sfandetti/meetorbit/LICENSING.md

# Licensing

Copyright (c) 2026 Seth Fandetti for original Orbit work.

- Original software, firmware, website and software documentation: **MIT**, see root `LICENSE`.
- Original Capsule hardware design files, CAD, STL, 3MF, wiring and build documentation under `hardware/`: **CERN-OHL-P-2.0**, see `hardware/LICENSE` and `hardware/NOTICE.md`.
- Font files and rasterized font data retain their upstream **SIL Open Font License 1.1** notices in `software/console/fonts/*-OFL.txt`. They are not relicensed as MIT.
- Third-party dependencies and their trademarks retain their respective terms. See `THIRD_PARTY_NOTICES.md`.

Neither license grants rights in third-party trademarks or implies endorsement by AI providers, Philips Hue, Espressif or component manufacturers. These files document a prototype and are supplied without warranty under the applicable licenses.
