sfandetti/meetorbit/THIRD_PARTY_NOTICES.md

# Third-party notices

- `ws` is installed from the pinned package lock by `npm ci`; node_modules is not distributed. Its upstream license remains applicable.
- Office, Retro, Cyber and Bubble fonts and firmware rasterized font data retain SIL Open Font License 1.1 notices in `software/console/fonts/*-OFL.txt`. Those notices are included in source archives.
- Arduino/ESP32, TFT_eSPI, XPT2046_Touchscreen and other external toolchain libraries are not bundled here; install and retain their upstream licenses. Exact library version pinning is a remaining firmware-release task.
- FFmpeg binaries are not distributed. Install a suitable dependency for camera recording and follow its applicable license.
- Legacy reference code is included as development history, not as the recommended current entry point.
- Older Halo/MakerWorld reference enclosure experiments and manufacturer schematic pages from private design research are excluded from this public package.
- Product/provider names and logos identify compatible external products and do not imply endorsement.

Original Orbit work and its license scope are described in LICENSING.md. No API credentials, installed profiles, recordings or pairing state are intended to be included.
