sfandetti/meetorbit/docs/RELEASE-CHECKLIST.md

# Development release status

Published as source for inspection, experimentation and contributions. An assembled product, signed installer and matched prebuilt firmware are not released yet.

- [x] Include original Capsule source, parts list, guides and device screenshots.
- [x] Include MIT and CERN-OHL-P-2.0 licenses and font notices.
- [x] Exclude private runtime state and network/pairing-detail captures.
- [ ] Validate setup on a clean Windows account.
- [ ] Pin Arduino/core/library versions and verify matched firmware on hardware.
- [ ] Validate pairing, voice, reviewed approvals, privacy confirmation and update recovery on the actual device.
- [ ] Prepare installer/firmware artifacts and release notes after validation.
- [ ] Develop the smaller hardware revision and dedicated PCB before production sales.

See VALIDATION.md for checks actually performed for this source publication.
