sfandetti/meetorbit/docs/SCREENSHOTS.md

# Device screenshots

Updated from the saved capture folder on 28 October 2026. No hardware capture or display-control requests were made to prepare this update. Original images are preserved: 42 landscape, 42 portrait and 8 theme samples. Network/pairing details are excluded. One landscape file named ai-face contains an alternate Home view; its gallery label reflects the actual image.

## Home and AI

### Home shortcuts

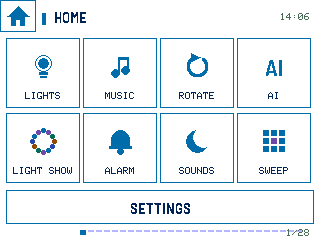
[picture p8: website/assets/screens/lying/home.png]
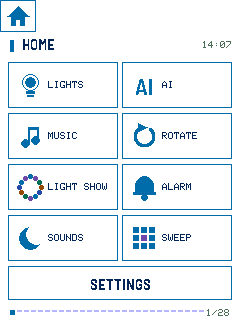
[picture p9: website/assets/screens/standing/home.png]
 

### AI engine picker

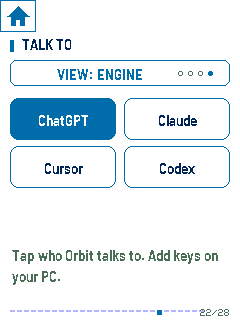
[picture p10: website/assets/screens/standing/ai-engine.png]
Landscape 

### AI console

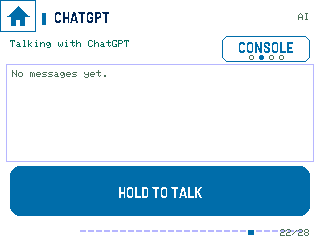
[picture p11: website/assets/screens/lying/ai-console.png]
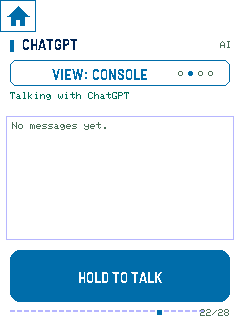
[picture p12: website/assets/screens/standing/ai-console.png]
 

## Alarm and ambient sounds

### Alarm clock

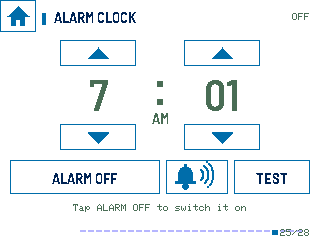
[picture p13: website/assets/screens/lying/alarm-clock.png]
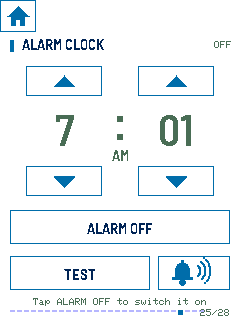
[picture p14: website/assets/screens/standing/alarm-clock.png]
 

### Alarm ringing / snooze

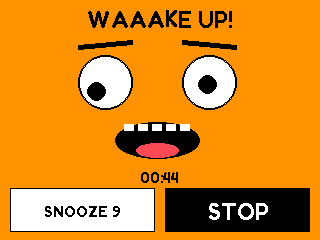
[picture p15: website/assets/screens/lying/alarm-ringing.png]
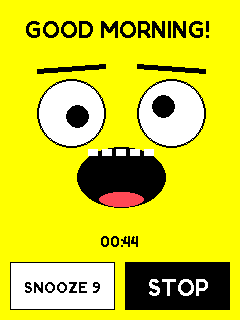
[picture p16: website/assets/screens/standing/alarm-ringing.png]
 

### Ambient sound machine

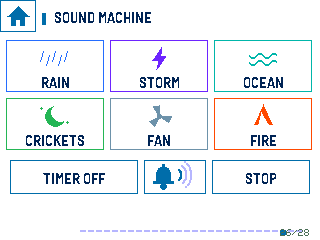
[picture p17: website/assets/screens/lying/sound-machine.png]
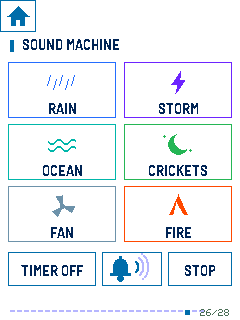
[picture p18: website/assets/screens/standing/sound-machine.png]
 

## Hue and lighting

### Hue room controls

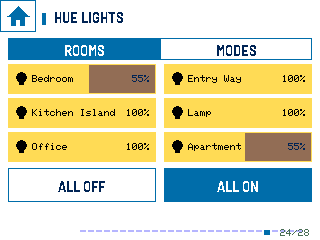
[picture p19: website/assets/screens/lying/hue-rooms.png]
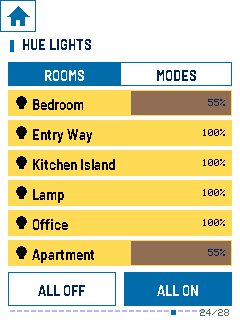
[picture p20: website/assets/screens/standing/hue-rooms.png]
 

### Hue modes / Music Link

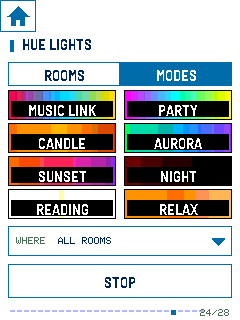
[picture p21: website/assets/screens/standing/hue-modes.png]
Landscape 

### LED light show

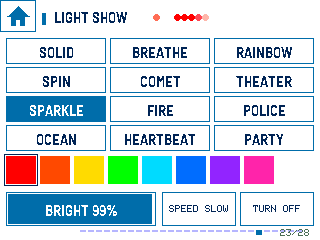
[picture p22: website/assets/screens/lying/light-show.png]
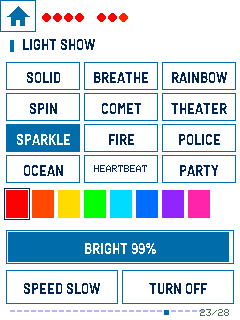
[picture p23: website/assets/screens/standing/light-show.png]
 

## PC and camera

### Six-channel dashboard

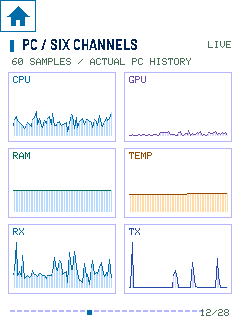
[picture p24: website/assets/screens/standing/six-channels.png]
Landscape 

### PC Matrix

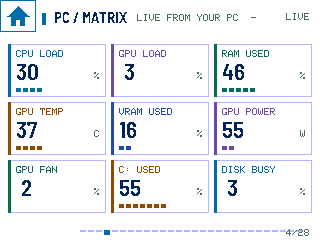
[picture p25: website/assets/screens/lying/pc-matrix.png]
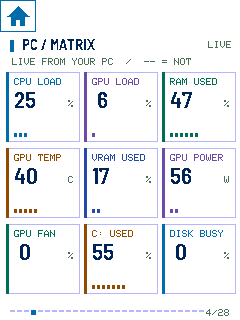
[picture p26: website/assets/screens/standing/pc-matrix.png]
 

### AI Sentry

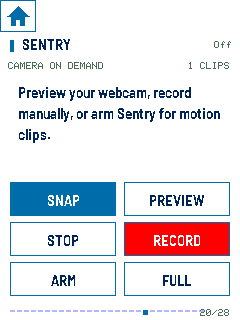
[picture p27: website/assets/screens/standing/sentry.png]
Landscape 

## Games

### Orbit Sweep

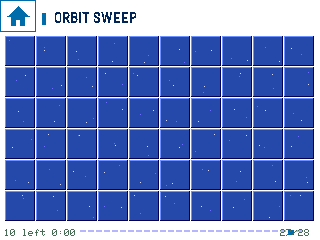
[picture p28: website/assets/screens/lying/orbit-sweep.png]
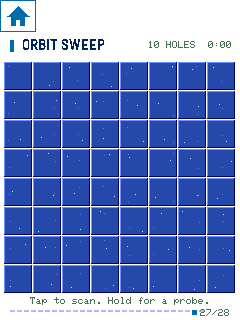
[picture p29: website/assets/screens/standing/orbit-sweep.png]
 

### Orbit Run

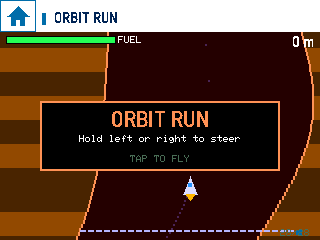
[picture p30: website/assets/screens/lying/orbit-run.png]
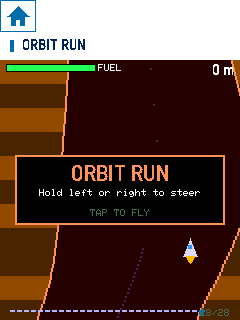
[picture p31: website/assets/screens/standing/orbit-run.png]
 

## Four themes

### Office

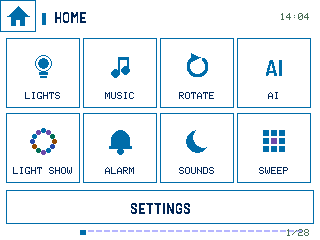
[picture p32: website/assets/screens/themes/office-home.png]
Home
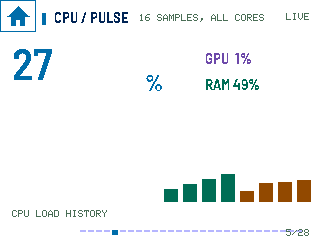
[picture p33: website/assets/screens/themes/office-cpu-pulse.png]
 

### Retro

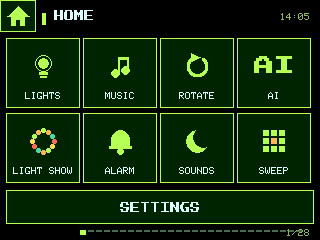
[picture p34: website/assets/screens/themes/retro-home.png]
Home
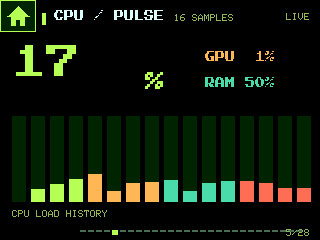
[picture p35: website/assets/screens/themes/retro-cpu-pulse.png]
 

### Cyberpunk

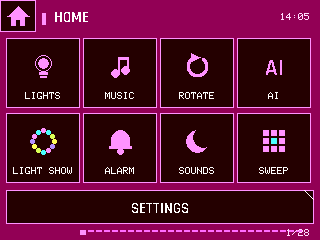
[picture p36: website/assets/screens/themes/cyberpunk-home.png]
Home
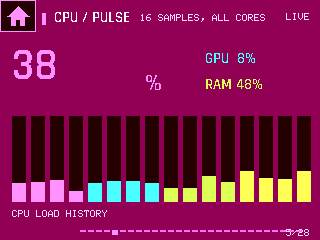
[picture p37: website/assets/screens/themes/cyberpunk-cpu-pulse.png]
 

### Bubblegum

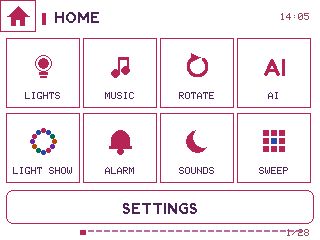
[picture p38: website/assets/screens/themes/bubblegum-home.png]
Home
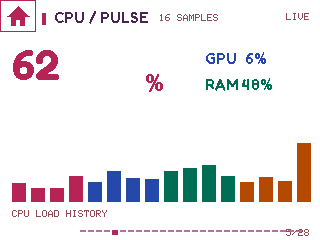
[picture p39: website/assets/screens/themes/bubblegum-cpu-pulse.png]
 

[All landscape captures](../website/assets/screens/lying/) · [All portrait captures](../website/assets/screens/standing/) · [Image hashes](SCREENSHOT-MANIFEST.json)
