sfandetti/meetorbit/branding/orbit-mark-github-512.png

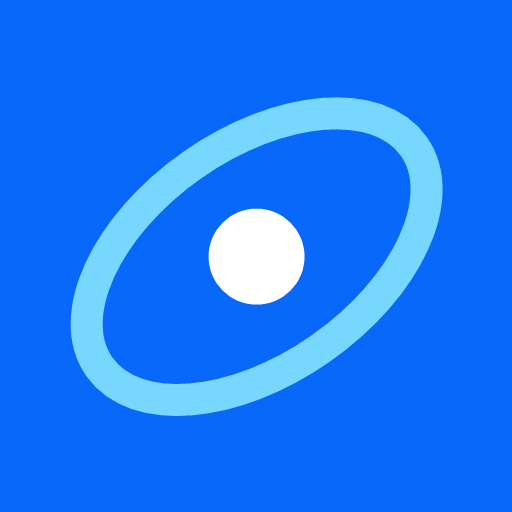
branding/orbit-mark-github-512.png
