sfandetti/meetorbit/hardware/CAD/_render_meshes/screen_ui.png

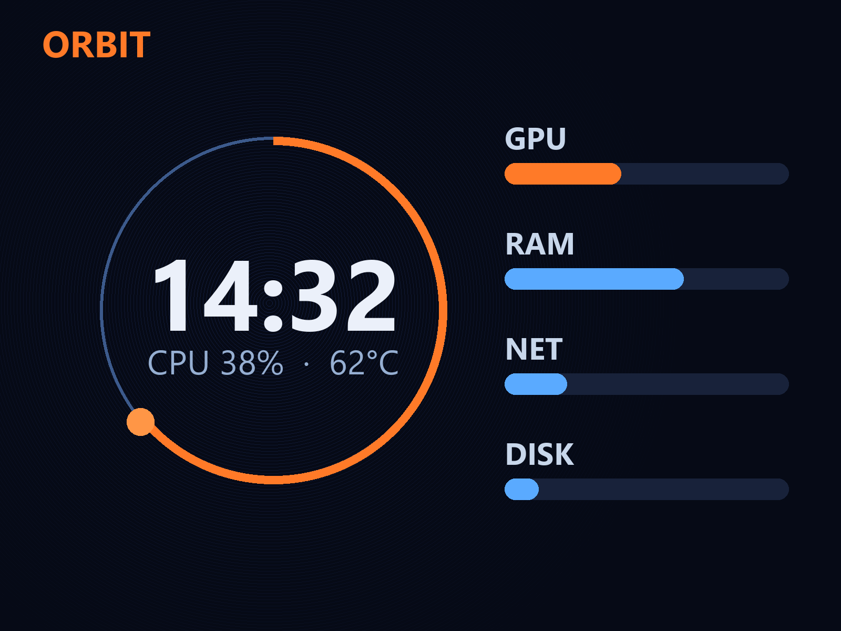
hardware/CAD/_render_meshes/screen_ui.png
