sfandetti/meetorbit/hardware/CAD/_render_meshes/screen_ui_portrait.png

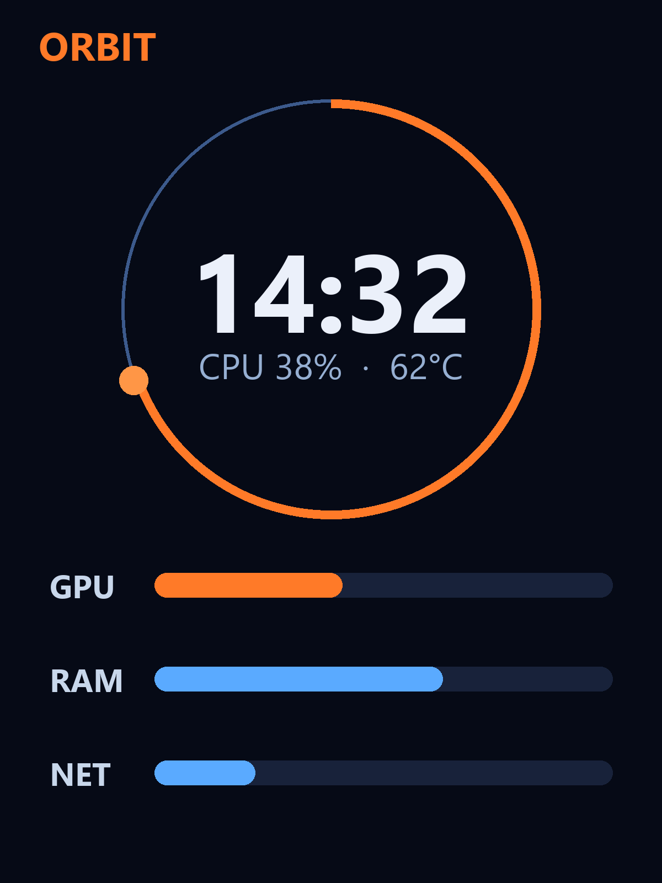
hardware/CAD/_render_meshes/screen_ui_portrait.png
