sfandetti/meetorbit/software/assets/orbit-enclosure-landscape.png

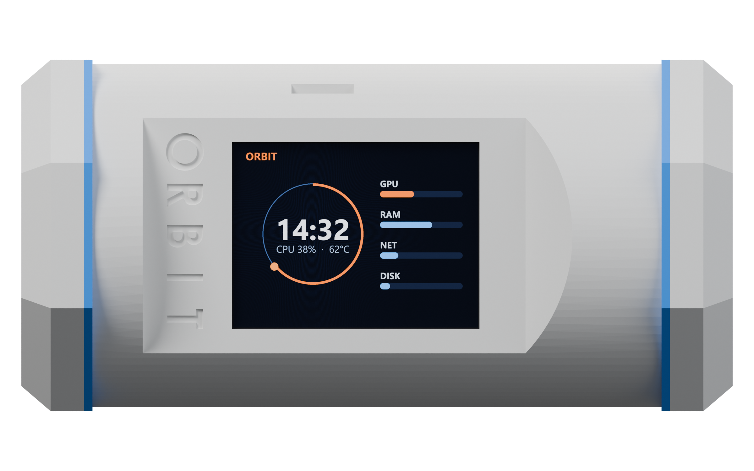
software/assets/orbit-enclosure-landscape.png
