sfandetti/meetorbit/software/assets/orbit-enclosure-portrait.png

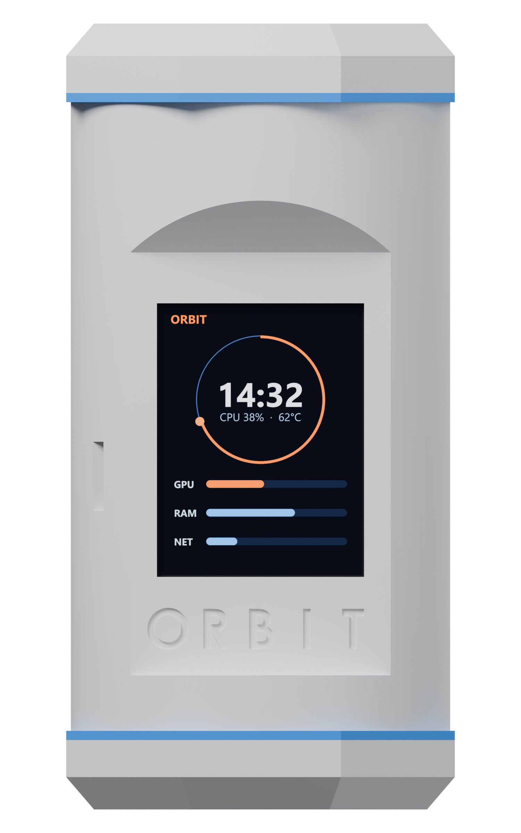
software/assets/orbit-enclosure-portrait.png
