sfandetti/meetorbit/website/assets/console-ai.png

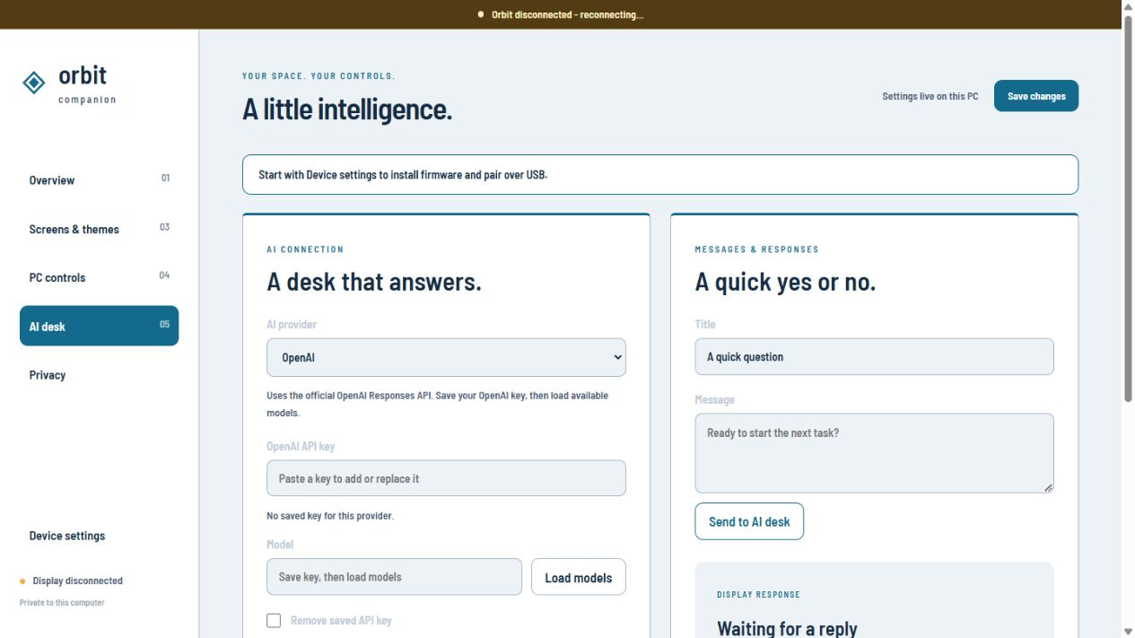
website/assets/console-ai.png
