sfandetti/meetorbit/website/assets/console-controls.png

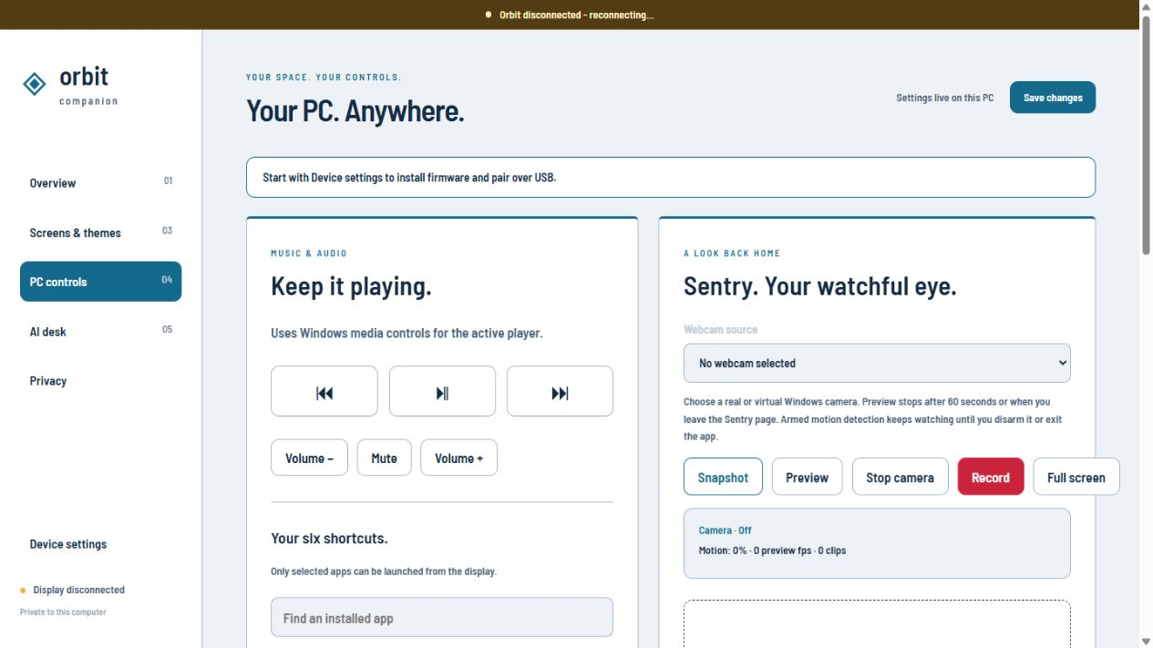
website/assets/console-controls.png
