sfandetti/meetorbit/website/assets/console-current-ai.png

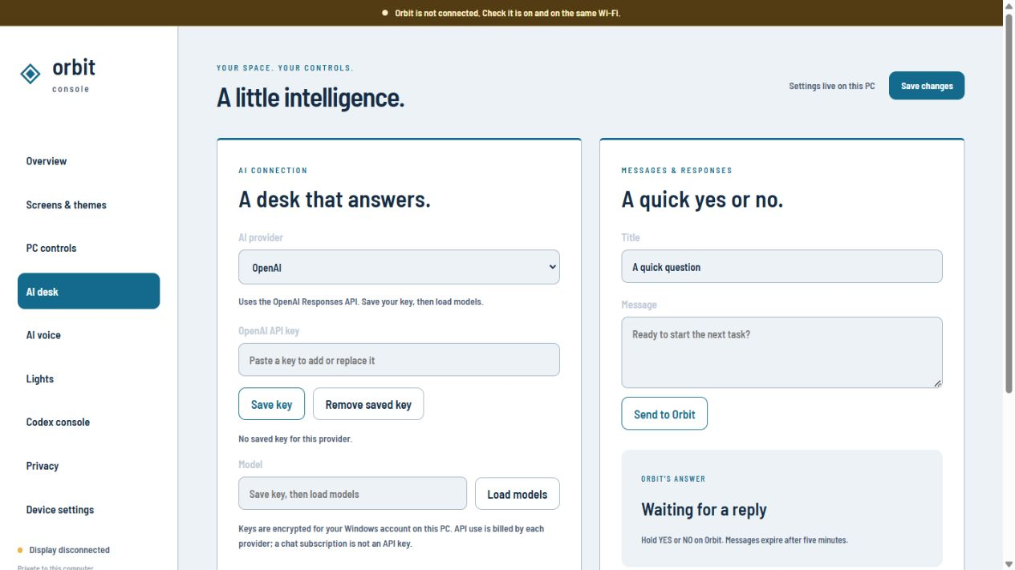
website/assets/console-current-ai.png
