sfandetti/meetorbit/website/assets/console-current-codex.png

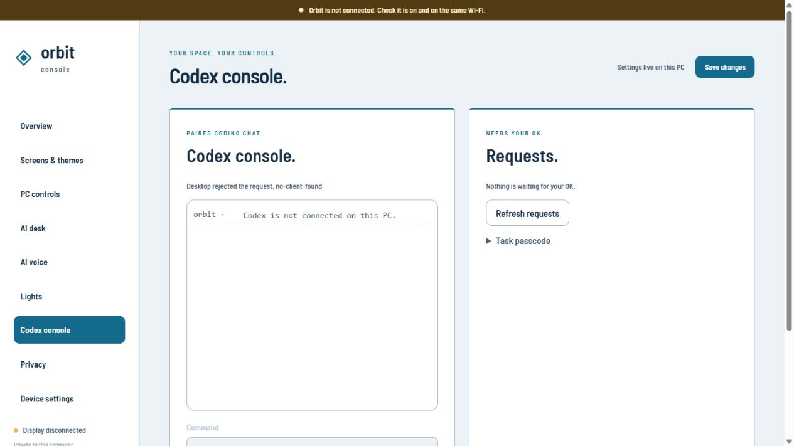
website/assets/console-current-codex.png
