sfandetti/meetorbit/website/assets/console-current-controls-full.png

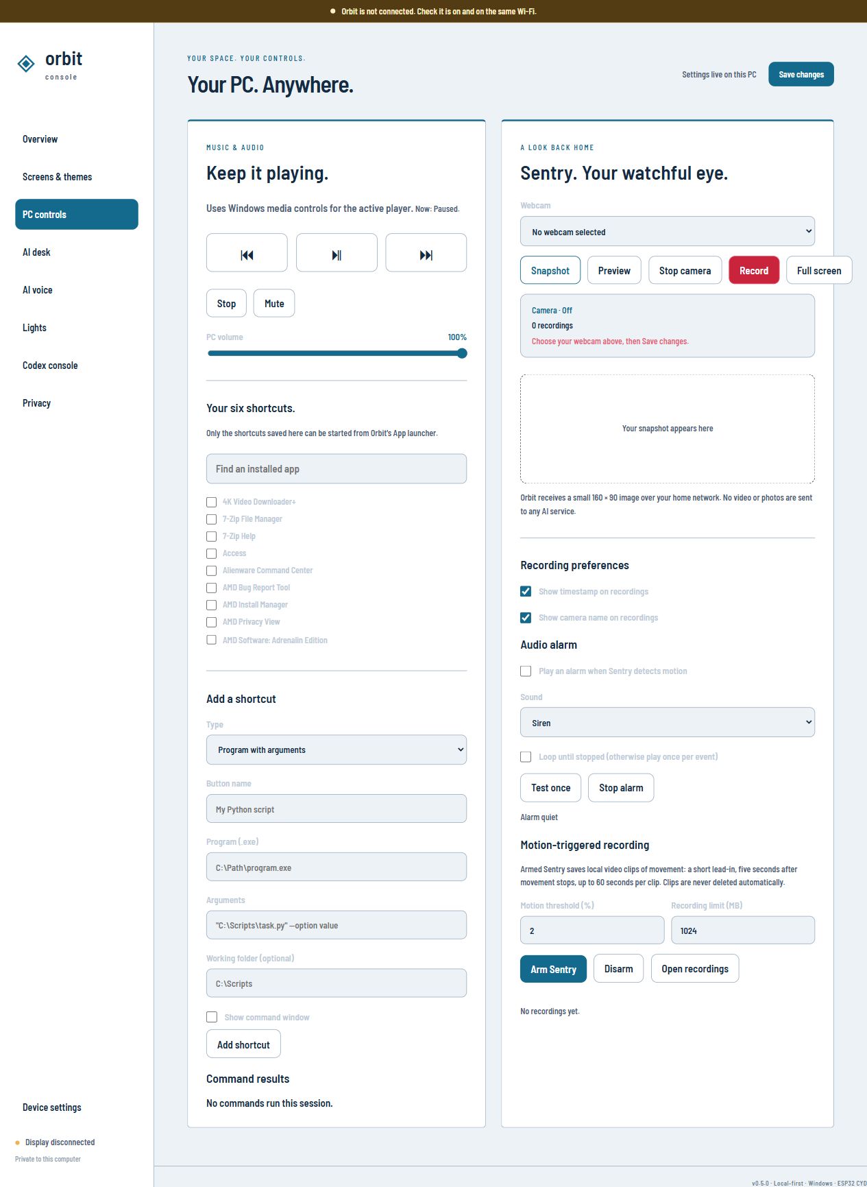
website/assets/console-current-controls-full.png
