sfandetti/meetorbit/website/assets/console-current-controls.png

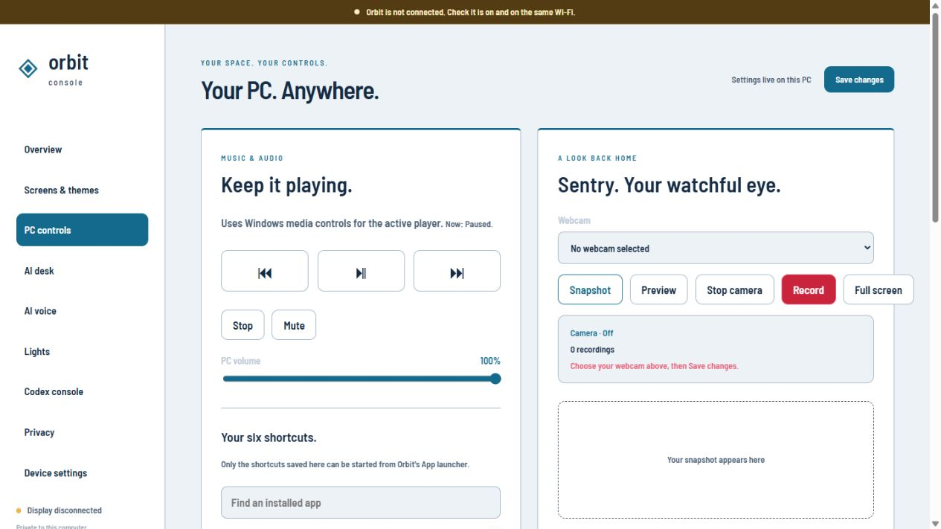
website/assets/console-current-controls.png
