sfandetti/meetorbit/website/assets/console-current-device.png

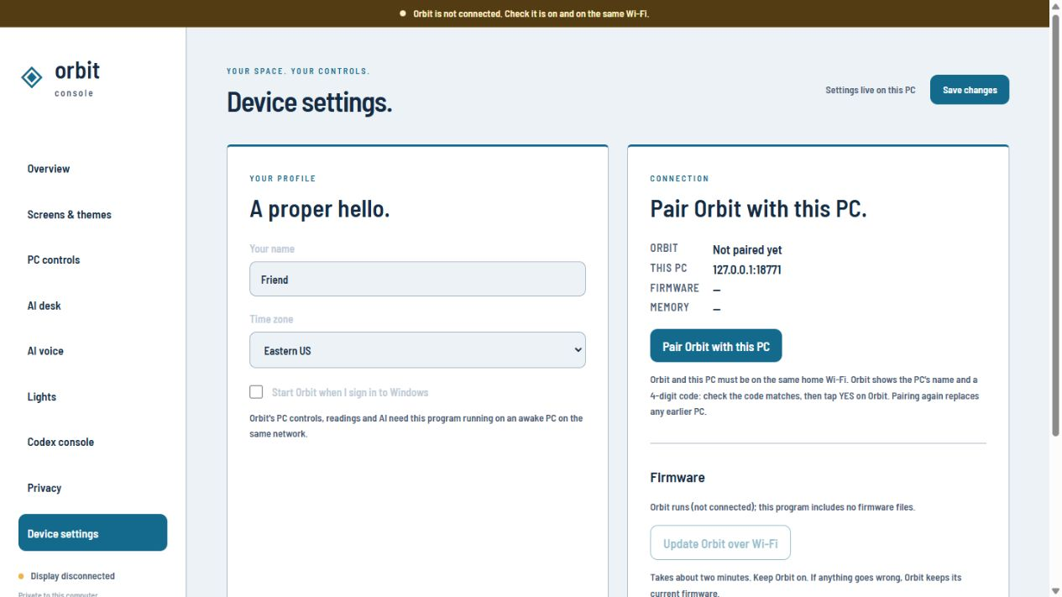
website/assets/console-current-device.png
