sfandetti/meetorbit/website/assets/console-current-lights.png

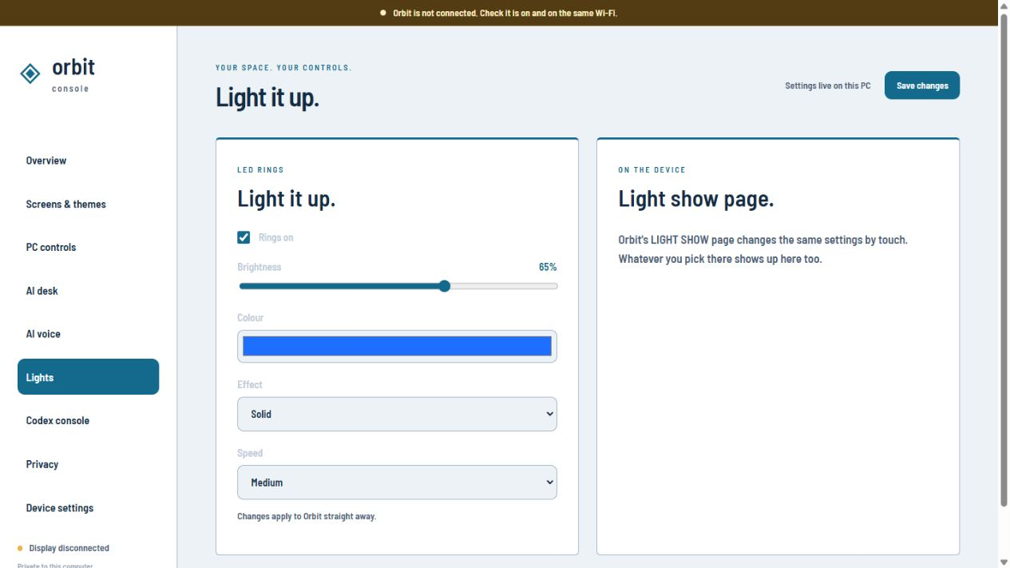
website/assets/console-current-lights.png
