sfandetti/meetorbit/website/assets/console-current-privacy-full.png

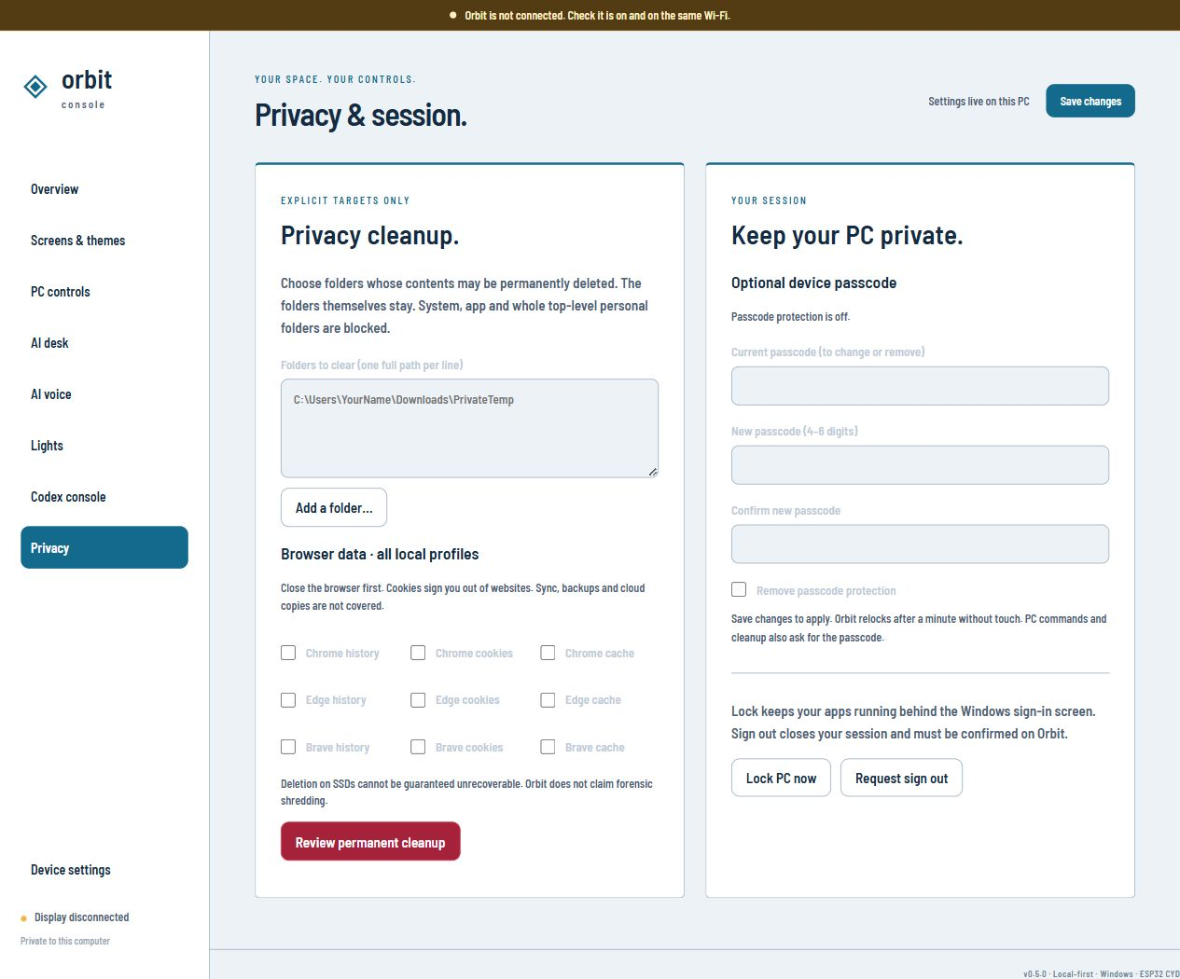
website/assets/console-current-privacy-full.png
