sfandetti/meetorbit/website/assets/console-current-privacy.png

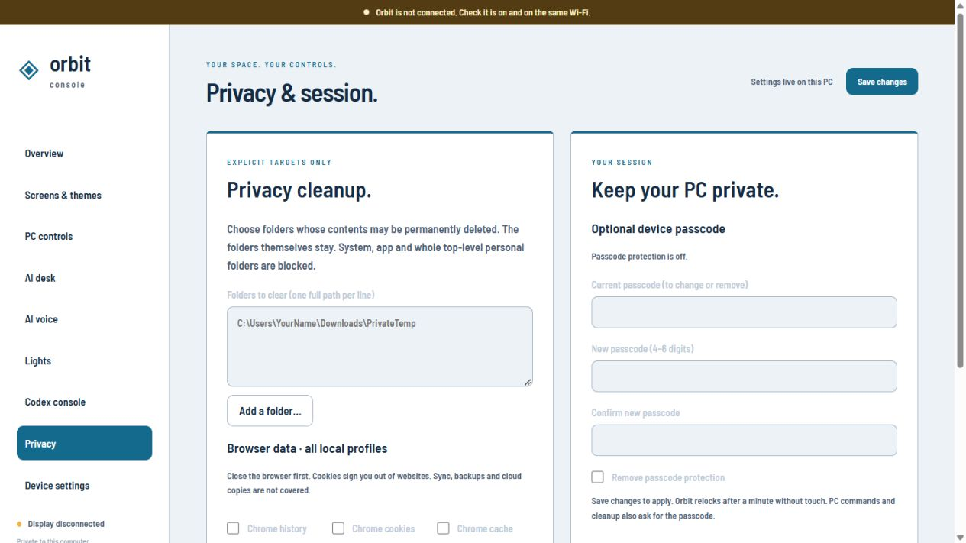
website/assets/console-current-privacy.png
