sfandetti/meetorbit/website/assets/console-current-themes.png

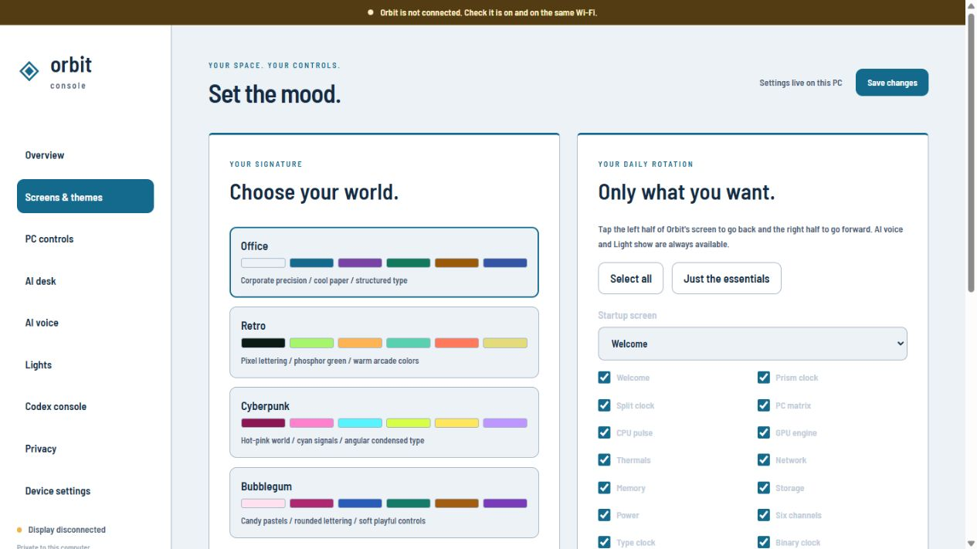
website/assets/console-current-themes.png
