sfandetti/meetorbit/website/assets/console-current-voice.png

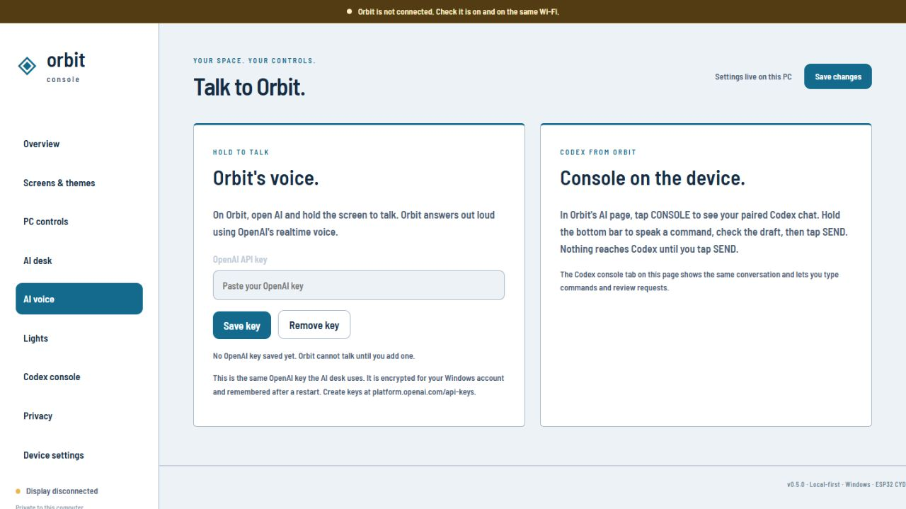
website/assets/console-current-voice.png
