sfandetti/meetorbit/website/assets/console-lights.png

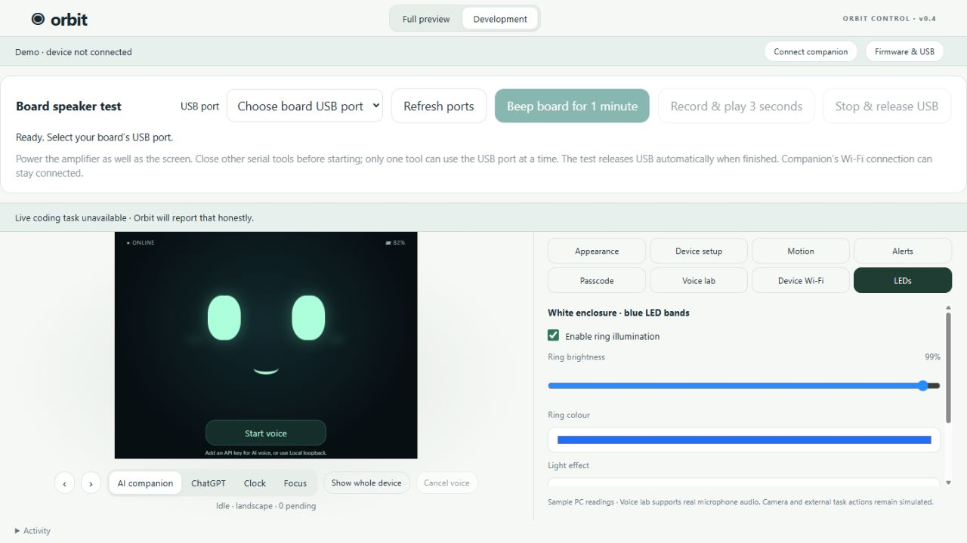
website/assets/console-lights.png
