sfandetti/meetorbit/website/assets/console-themes.png

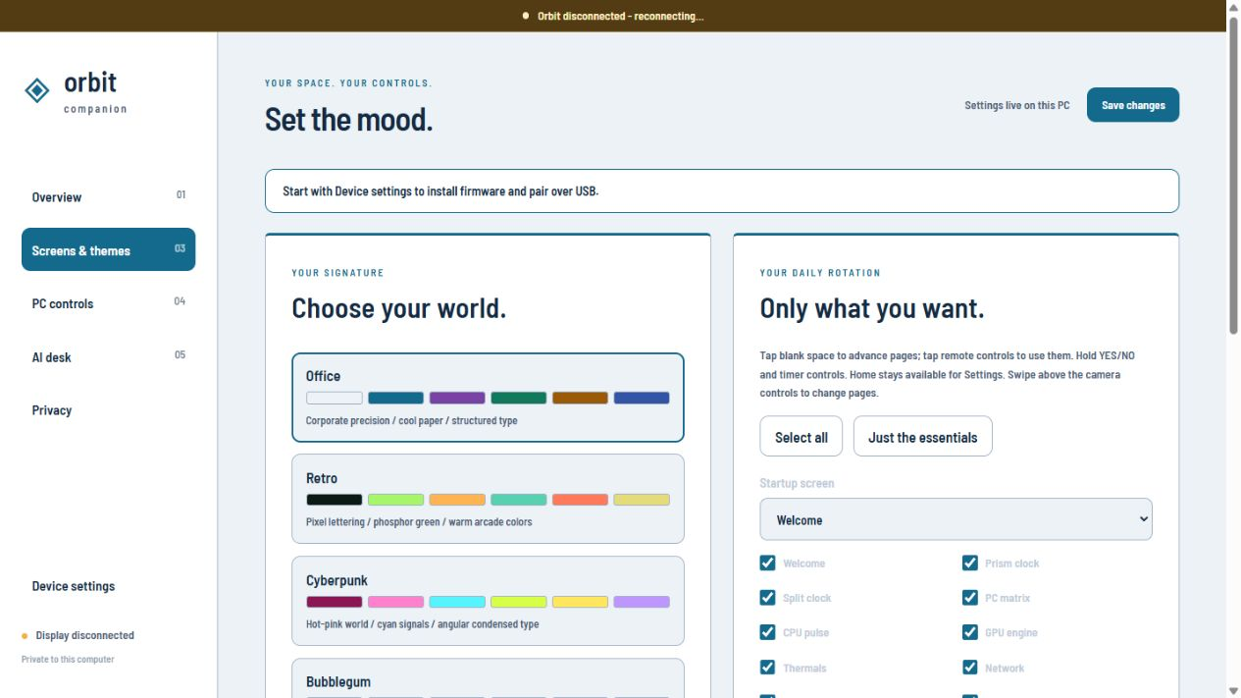
website/assets/console-themes.png
