sfandetti/meetorbit/website/assets/orbit-capsule-blue.png

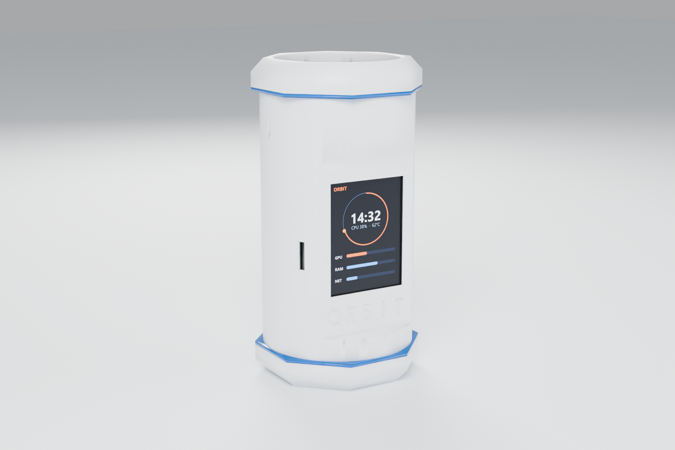
website/assets/orbit-capsule-blue.png
