sfandetti/meetorbit/website/assets/orbit-capsule.png

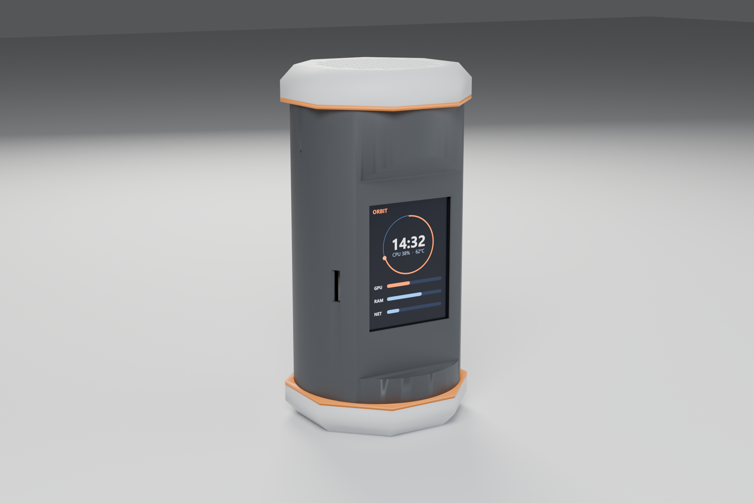
website/assets/orbit-capsule.png
