sfandetti/meetorbit/website/assets/orbit-cutaway-blue.png

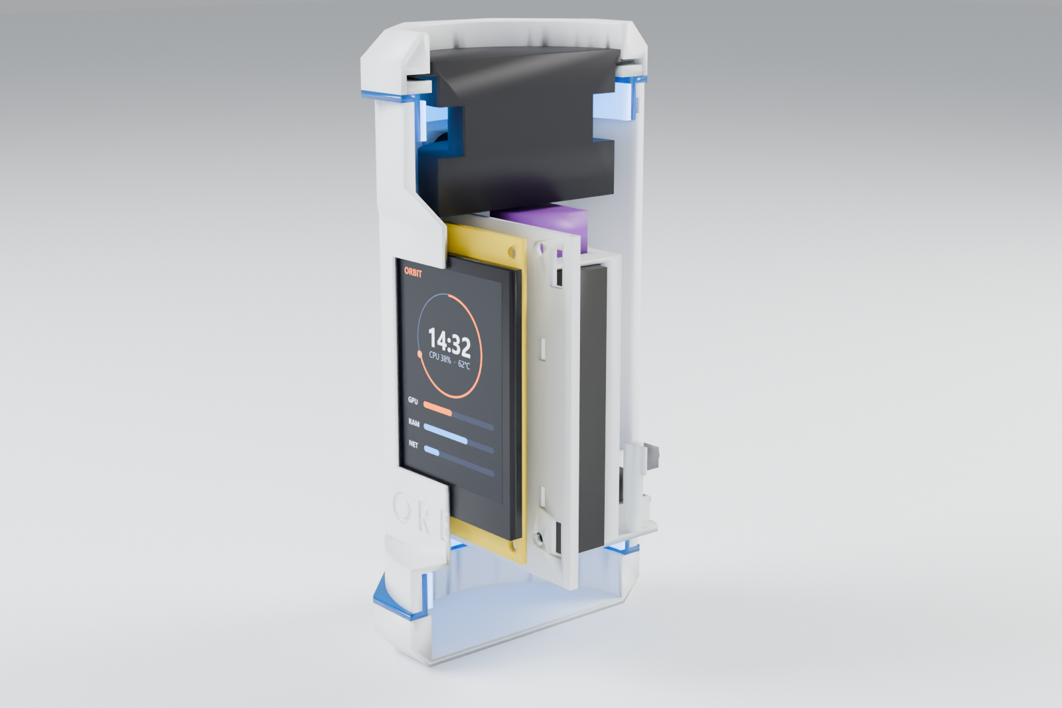
website/assets/orbit-cutaway-blue.png
