sfandetti/meetorbit/website/assets/orbit-cutaway.png

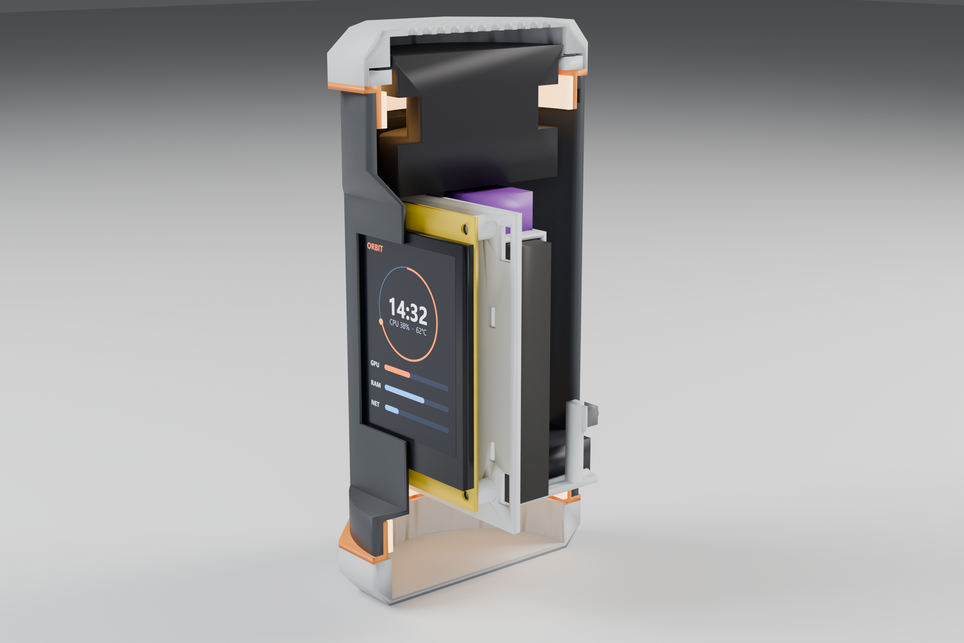
website/assets/orbit-cutaway.png
