sfandetti/meetorbit/website/assets/orbit-exploded-blue.png

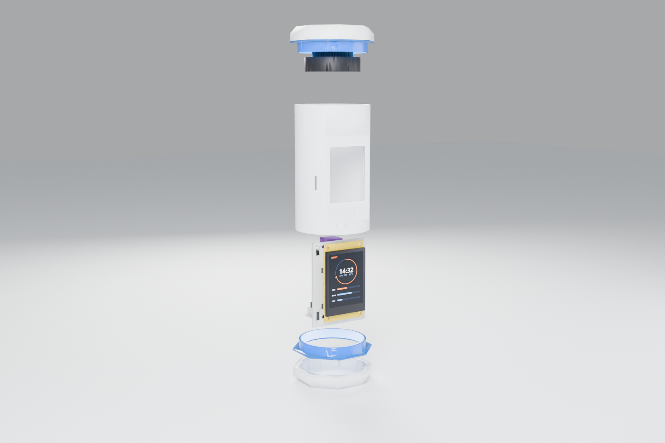
website/assets/orbit-exploded-blue.png
