sfandetti/meetorbit/website/assets/orbit-exploded.png

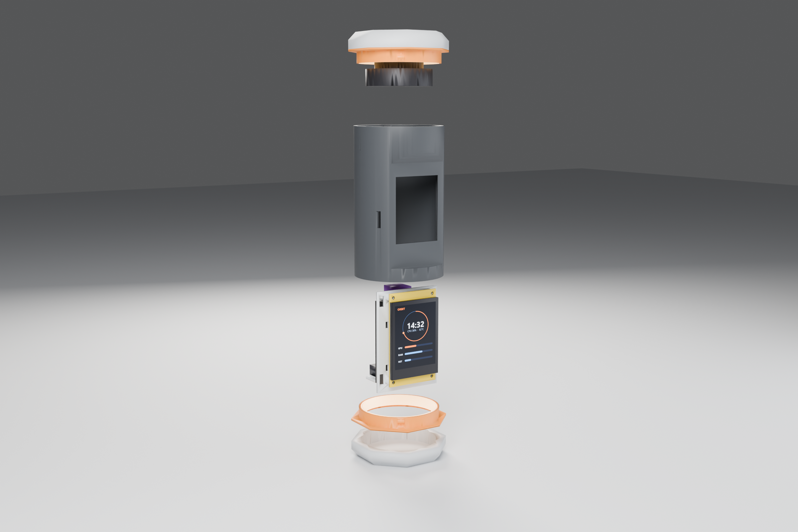
website/assets/orbit-exploded.png
