sfandetti/meetorbit/website/assets/orbit-speaker.jpg

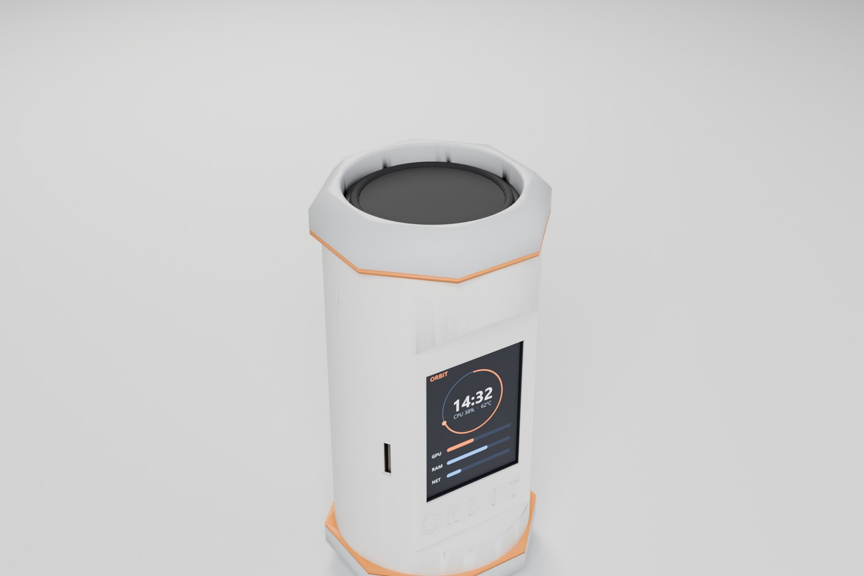
website/assets/orbit-speaker.jpg
