sfandetti/meetorbit/website/assets/orbit-two-views-crisp.png

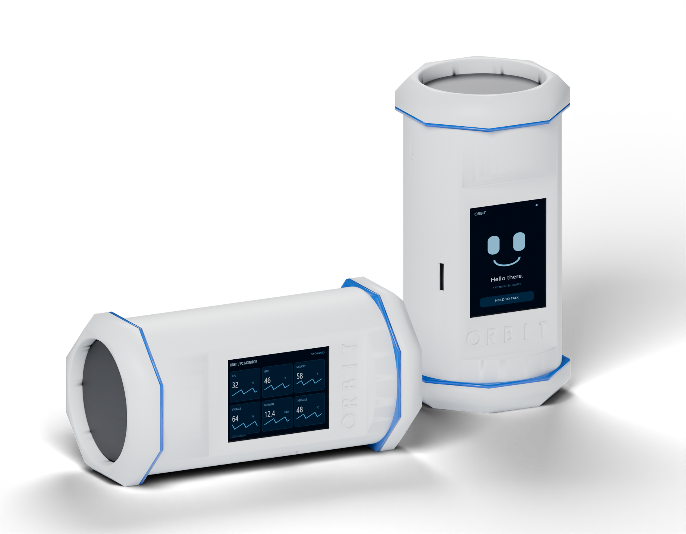
website/assets/orbit-two-views-crisp.png
