sfandetti/meetorbit/website/assets/orbit-two-views-reversed.png

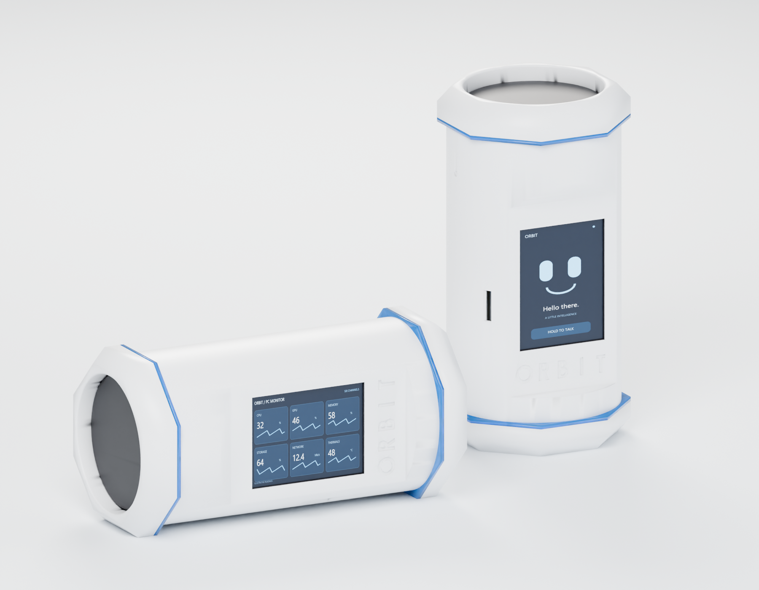
website/assets/orbit-two-views-reversed.png
