sfandetti/meetorbit/website/assets/orbit-two-views.png

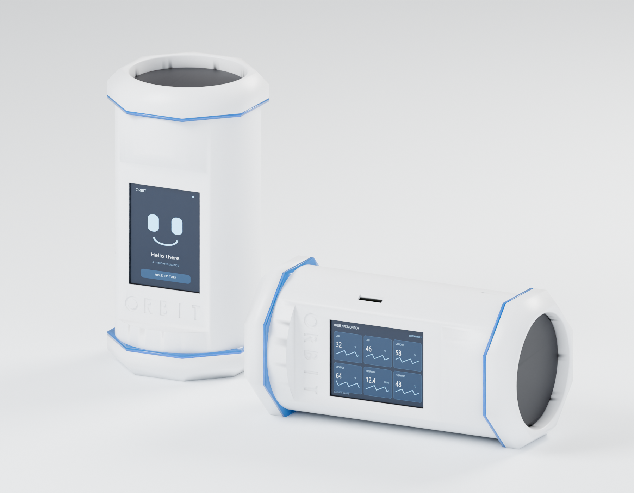
website/assets/orbit-two-views.png
