sfandetti/meetorbit/website/assets/screens/lying/ai-talk.png

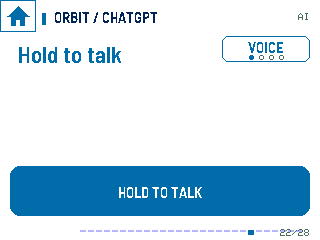
website/assets/screens/lying/ai-talk.png
