sfandetti/meetorbit/website/assets/screens/lying/app-launcher.png

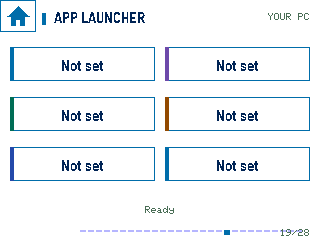
website/assets/screens/lying/app-launcher.png
