sfandetti/meetorbit/website/assets/screens/lying/binary-clock.png

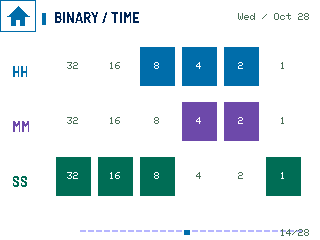
website/assets/screens/lying/binary-clock.png
