sfandetti/meetorbit/website/assets/screens/lying/cpu-pulse.png

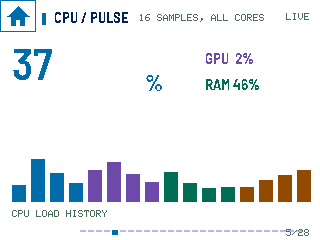
website/assets/screens/lying/cpu-pulse.png
