sfandetti/meetorbit/website/assets/screens/lying/focus.png

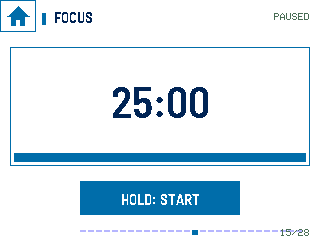
website/assets/screens/lying/focus.png
