sfandetti/meetorbit/website/assets/screens/lying/gpu-engine.png

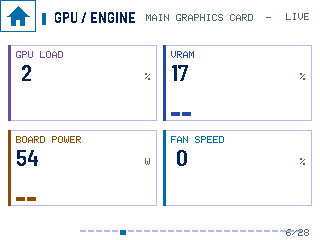
website/assets/screens/lying/gpu-engine.png
