sfandetti/meetorbit/website/assets/screens/lying/memory-blocks.png

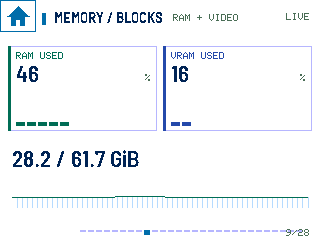
website/assets/screens/lying/memory-blocks.png
