sfandetti/meetorbit/website/assets/screens/lying/music.png

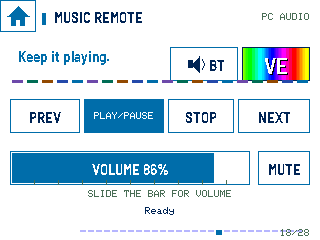
website/assets/screens/lying/music.png
