sfandetti/meetorbit/website/assets/screens/lying/network-stream.png

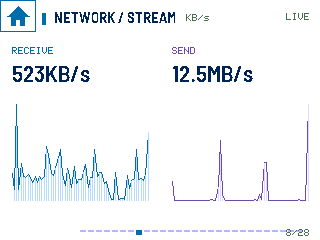
website/assets/screens/lying/network-stream.png
