sfandetti/meetorbit/website/assets/screens/lying/power-drive.png

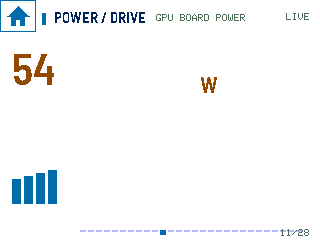
website/assets/screens/lying/power-drive.png
