sfandetti/meetorbit/website/assets/screens/lying/prism-clock.png

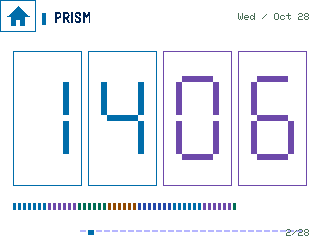
website/assets/screens/lying/prism-clock.png
