sfandetti/meetorbit/website/assets/screens/lying/privacy-guard.png

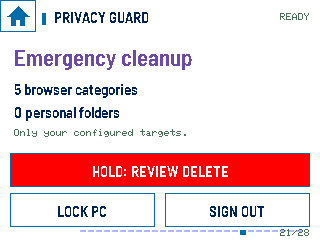
website/assets/screens/lying/privacy-guard.png
