sfandetti/meetorbit/website/assets/screens/lying/split-clock.png

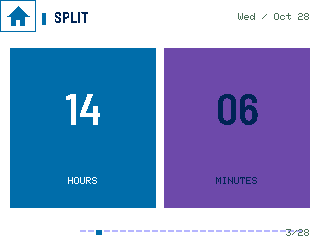
website/assets/screens/lying/split-clock.png
