sfandetti/meetorbit/website/assets/screens/lying/stopwatch.png

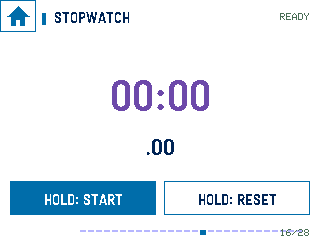
website/assets/screens/lying/stopwatch.png
