sfandetti/meetorbit/website/assets/screens/lying/storage-traffic.png

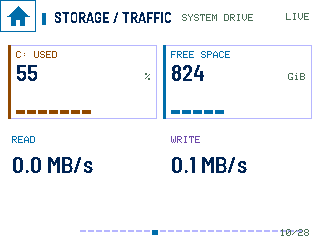
website/assets/screens/lying/storage-traffic.png
