sfandetti/meetorbit/website/assets/screens/lying/thermal-strip.png

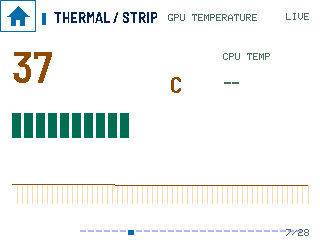
website/assets/screens/lying/thermal-strip.png
