sfandetti/meetorbit/website/assets/screens/lying/type-clock.png

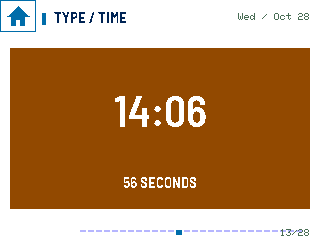
website/assets/screens/lying/type-clock.png
