sfandetti/meetorbit/website/assets/screens/lying/visuals-1.png

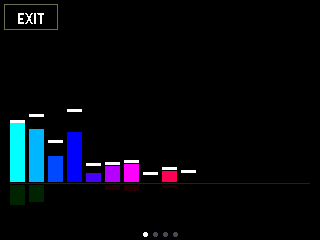
website/assets/screens/lying/visuals-1.png
