sfandetti/meetorbit/website/assets/screens/lying/visuals-3.png

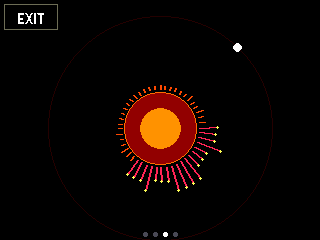
website/assets/screens/lying/visuals-3.png
