sfandetti/meetorbit/website/assets/screens/lying/visuals-4.png

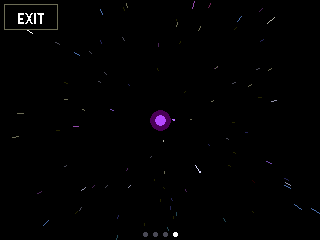
website/assets/screens/lying/visuals-4.png
