sfandetti/meetorbit/website/assets/screens/standing/ai-talk.png

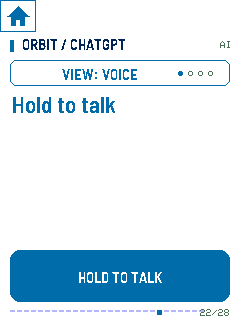
website/assets/screens/standing/ai-talk.png
