sfandetti/meetorbit/website/assets/screens/standing/app-launcher.png

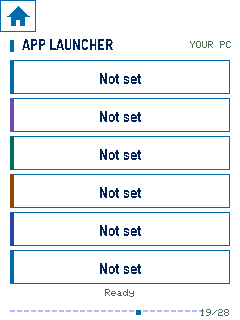
website/assets/screens/standing/app-launcher.png
