sfandetti/meetorbit/website/assets/screens/standing/binary-clock.png

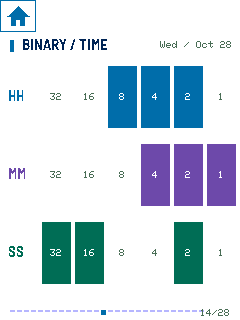
website/assets/screens/standing/binary-clock.png
