sfandetti/meetorbit/website/assets/screens/standing/cpu-pulse.png

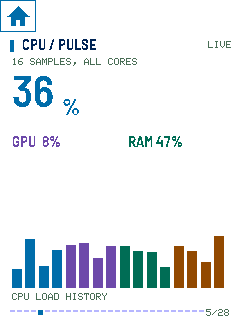
website/assets/screens/standing/cpu-pulse.png
