sfandetti/meetorbit/website/assets/screens/standing/focus.png

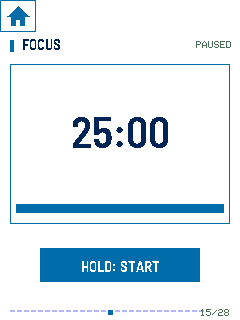
website/assets/screens/standing/focus.png
