sfandetti/meetorbit/website/assets/screens/standing/gpu-engine.png

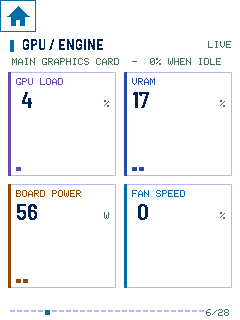
website/assets/screens/standing/gpu-engine.png
