sfandetti/meetorbit/website/assets/screens/standing/memory-blocks.png

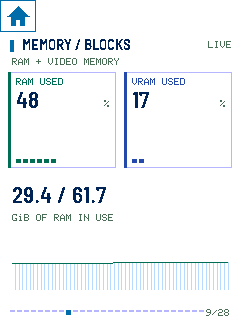
website/assets/screens/standing/memory-blocks.png
