sfandetti/meetorbit/website/assets/screens/standing/music.png

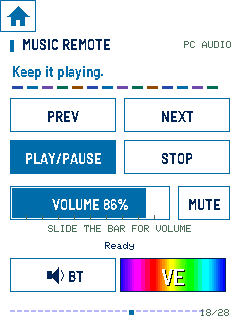
website/assets/screens/standing/music.png
