sfandetti/meetorbit/website/assets/screens/standing/network-stream.png

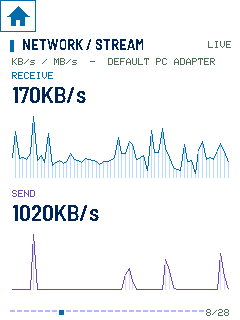
website/assets/screens/standing/network-stream.png
