sfandetti/meetorbit/website/assets/screens/standing/power-drive.png

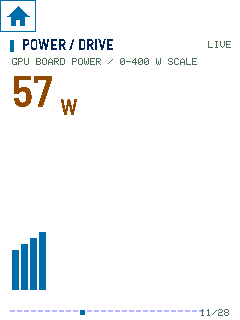
website/assets/screens/standing/power-drive.png
