sfandetti/meetorbit/website/assets/screens/standing/prism-clock.png

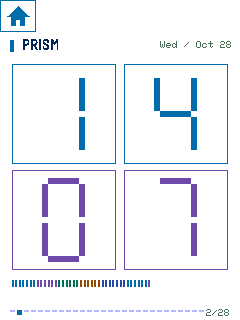
website/assets/screens/standing/prism-clock.png
