sfandetti/meetorbit/website/assets/screens/standing/privacy-guard.png

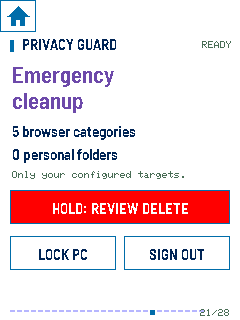
website/assets/screens/standing/privacy-guard.png
