sfandetti/meetorbit/website/assets/screens/standing/split-clock.png

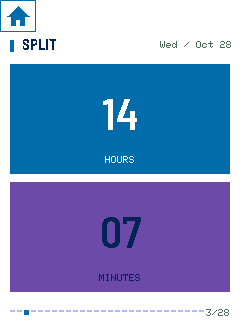
website/assets/screens/standing/split-clock.png
