sfandetti/meetorbit/website/assets/screens/standing/stopwatch.png

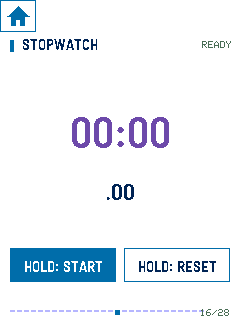
website/assets/screens/standing/stopwatch.png
