sfandetti/meetorbit/website/assets/screens/standing/storage-traffic.png

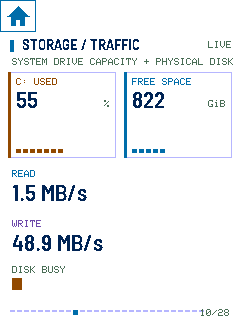
website/assets/screens/standing/storage-traffic.png
