sfandetti/meetorbit/website/assets/screens/standing/thermal-strip.png

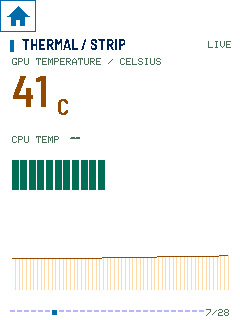
website/assets/screens/standing/thermal-strip.png
