sfandetti/meetorbit/website/assets/screens/standing/type-clock.png

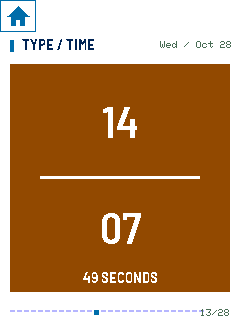
website/assets/screens/standing/type-clock.png
