sfandetti/meetorbit/website/assets/screens/standing/visuals-1.png

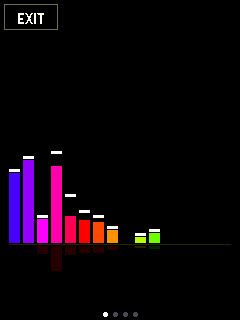
website/assets/screens/standing/visuals-1.png
