sfandetti/meetorbit/website/assets/screens/standing/visuals-2.png

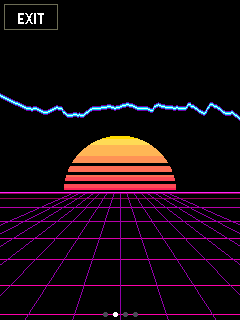
website/assets/screens/standing/visuals-2.png
