sfandetti/meetorbit/website/assets/screens/standing/visuals-3.png

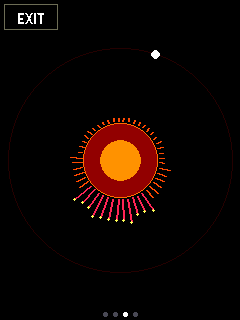
website/assets/screens/standing/visuals-3.png
