sfandetti/meetorbit/website/assets/screens/standing/visuals-4.png

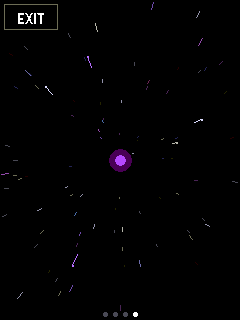
website/assets/screens/standing/visuals-4.png
