sfandetti/meetorbit/hardware/CAPSULE-PARTS.csv

Quantity | Component | Part / model | Specification / fit | Search terms | Evidence / status
1 | Display / controller board | ESP32-2432S028R (CYD) | 2.8-inch resistive touch; ESP32; match the board revision and connector arrangement | ESP32-2432S028R CYD 2.8 resistive touchscreen | Identified in existing hardware documentation
1 | Microphone module | INMP441 | I2S digital microphone breakout; VDD at 3.3 V per build guide | INMP441 I2S microphone module | Identified in Capsule build guide
1 | Audio amplifier module | MAX98357A | I2S amplifier breakout; separate from microphone and speaker | MAX98357A I2S amplifier breakout | Identified in Capsule build guide
1 | Speaker driver | Dayton Audio PC68-4 (Amazon listing model PC68-4-S) | 2.5-inch full-range driver; 4 ohm; 20 W RMS / 40 W max driver rating (not Orbit amplifier output); manufacturer frame 68 mm, depth 37 mm, cutout 64 mm. Existing prototype measurements retained in CAD. | Dayton Audio PC68-4 2.5 full range 4 ohm; https://www.amazon.com/dp/B0751FW9NP | Exact purchase link supplied by Seth; specifications: https://daytonaudio.com/product/1538/pc68-4-2-1-2-full-range-poly-cone-driver
1 | USB-C battery charger / 5 V boost board | Cermant charge/boost module | Capsule guide identifies Cermant. Earlier hardware list references Amazon ASIN B0GRV7F1LJ; exact Capsule purchase match needs confirmation. | Cermant Type C 5V 2A charger boost B0GRV7F1LJ | Module family identified; purchasing match requires confirmation
1 | Battery holder | Dual 18650 parallel holder | Measured external envelope 78 x 40 x 22 mm; match wiring and clearances | 2 x 18650 parallel battery holder | Dimensions from Capsule CAD
2 | Battery cells | 18650 Li-ion | Matched cells; prototype guide uses a 1S parallel arrangement, never series into a 1S charger | 18650 matched Li-ion cells | Exact brand / capacity not recorded
8 LEDs total | Lighting | WS2812 addressable LEDs | Two chained 4-LED pieces; match current firmware pin map | WS2812 4 LED strip segment | Confirmed by firmware handoff
1 | LED data resistor | 330 ohm | Series data resistor from build guide | 330 ohm resistor | Identified in build guide
1 | Power button | 6 x 6 mm momentary tactile switch | Connect to charge/boost board power-key input according to wiring guide | 6x6mm tactile push button | Identified in build guide
3 | Board signal cables | JST 1.25 mm 4-pin pigtails | For P1 / CN1 / P3; verify connector fit and wire order; not JST GH | JST 1.25mm 4 pin connector with wire | Identified in build guide
1 | Programming cable | USB data cable matching CYD board port | Must support data, not charge-only | USB data cable for ESP32 CYD board | Check actual board connector revision
8 | Heat-set inserts | M3 x 5 x 4 | Match insert dimensions to the Capsule revision | M3 5mm length 4mm OD heat set insert | Capsule guide / CAD
8 | Assembly screws | M3 x 6 mm | Four screen mounts and four speaker mounts per guide | M3x6 screw | Capsule build guide
As needed | Wiring and assembly supplies | Hook-up wire, heat-shrink, solder, two small zip ties, adhesive | Wire gauge and fastening must suit the actual power path and revision | silicone hook up wire heat shrink solder | See illustrated assembly / wiring guides
1 set | Printed enclosure | Capsule v1 STL and 3MF set | Tube, lids, collars, sled, spacer, screen posts and button plungers; keep fit-test alternatives identified | See repository hardware/STL/Capsule_v1 and hardware/Print | Original prototype files included
