sfandetti/meetorbit/hardware/Print/1b_Capsule_SCREEN_POSTS_x20_sheet.3mf

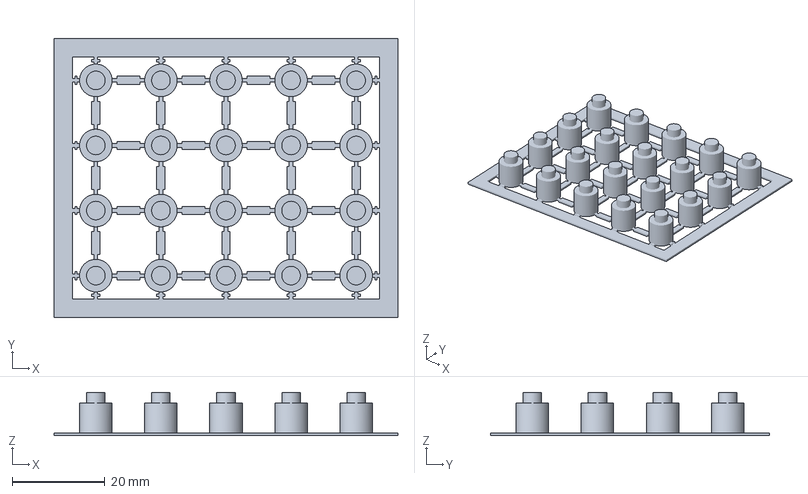
[picture p110: CAD file, 2026-10-28]
hardware/Print/1b_Capsule_SCREEN_POSTS_x20_sheet.3mf
74.0 x 60.0 x 9.29 mm
