sfandetti/meetorbit/hardware/STL/Capsule_v1/Orbit_Capsule_tube_TEST_band_plus_plungers.stl

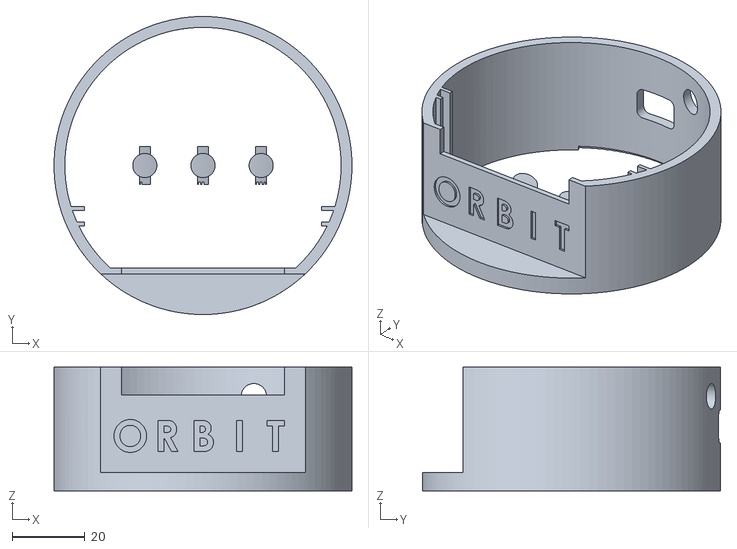
[picture p111: CAD file, 2026-10-28]
hardware/STL/Capsule_v1/Orbit_Capsule_tube_TEST_band_plus_plungers.stl
82.0 x 82.0 x 34.0
