sfandetti/meetorbit/hardware/Print/2_Capsule_TUBE_graphite.3mf

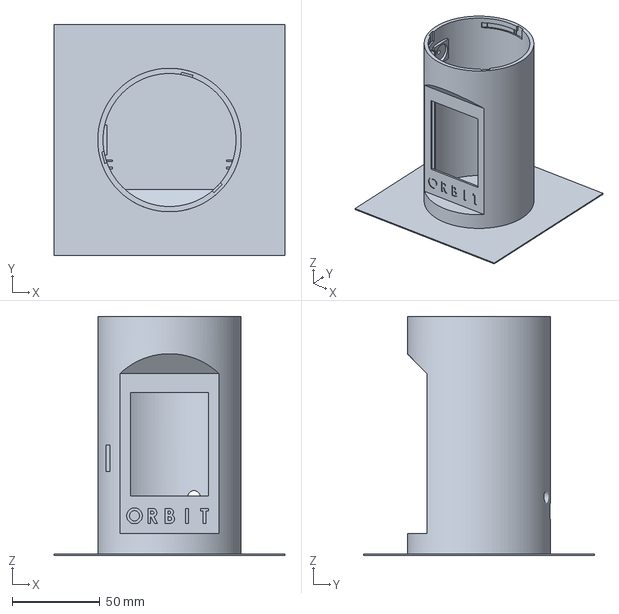
[picture p112: CAD file, 2026-10-28]
hardware/Print/2_Capsule_TUBE_graphite.3mf
132.0 x 132.0 x 136.6 mm
