sfandetti/meetorbit/hardware/STL/Capsule_v1/Orbit_Capsule_sled_print.stl

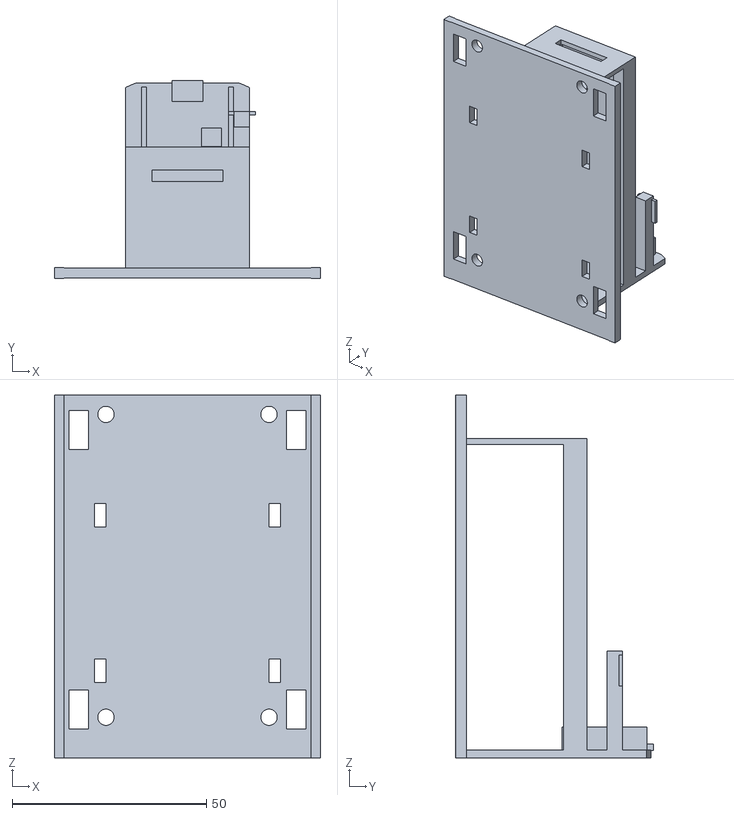
[picture p113: CAD file, 2026-10-28]
hardware/STL/Capsule_v1/Orbit_Capsule_sled_print.stl
68.6 x 50.9 x 93.5
