sfandetti/meetorbit/hardware/Print/0_Capsule_TEST_speaker_hole_ring.3mf

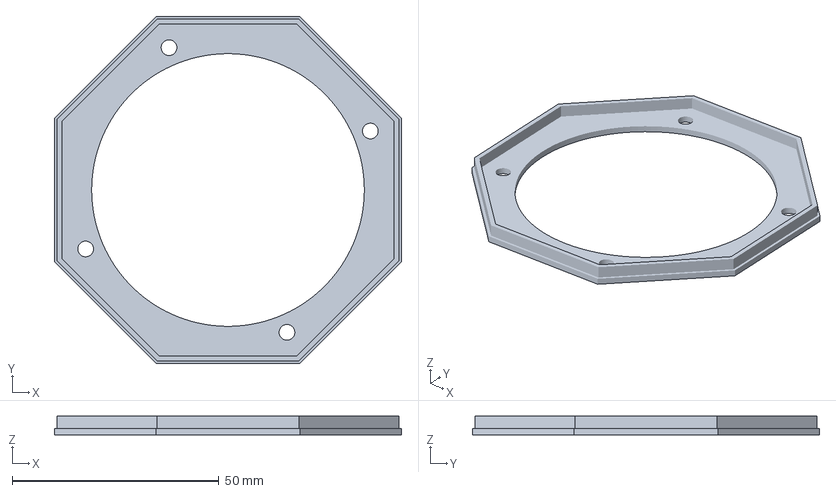
[picture p114: CAD file, 2026-10-28]
hardware/Print/0_Capsule_TEST_speaker_hole_ring.3mf
84.0 x 84.0 x 4.59 mm
