sfandetti/meetorbit/hardware/STL/Capsule_v1/Orbit_Capsule_button.stl

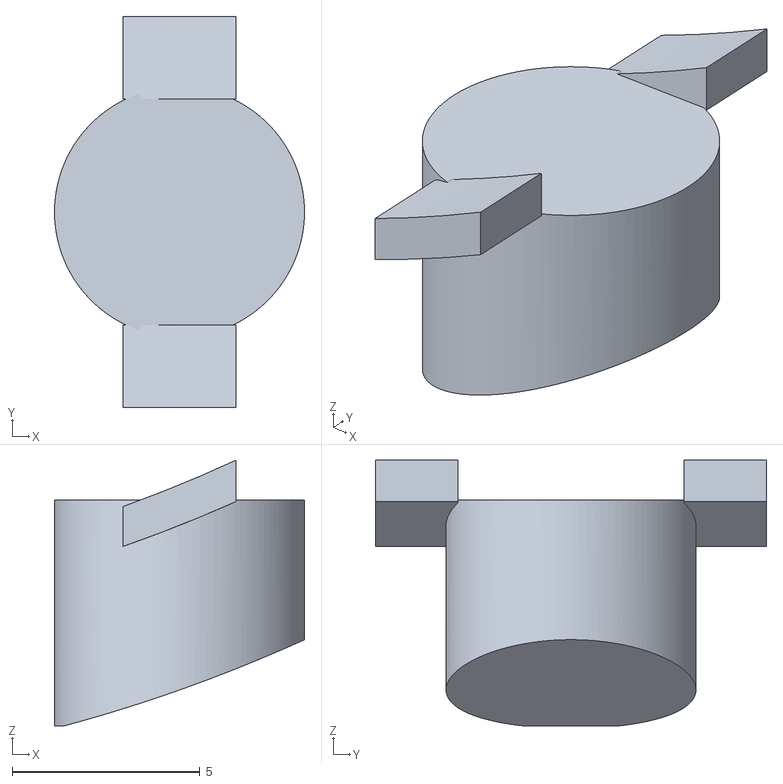
[picture p115: CAD file, 2026-10-28]
hardware/STL/Capsule_v1/Orbit_Capsule_button.stl
6.65 x 10.4 x 7.06
