sfandetti/meetorbit/hardware/Print/1_Capsule_SLED_and_spacer_any_colour.3mf

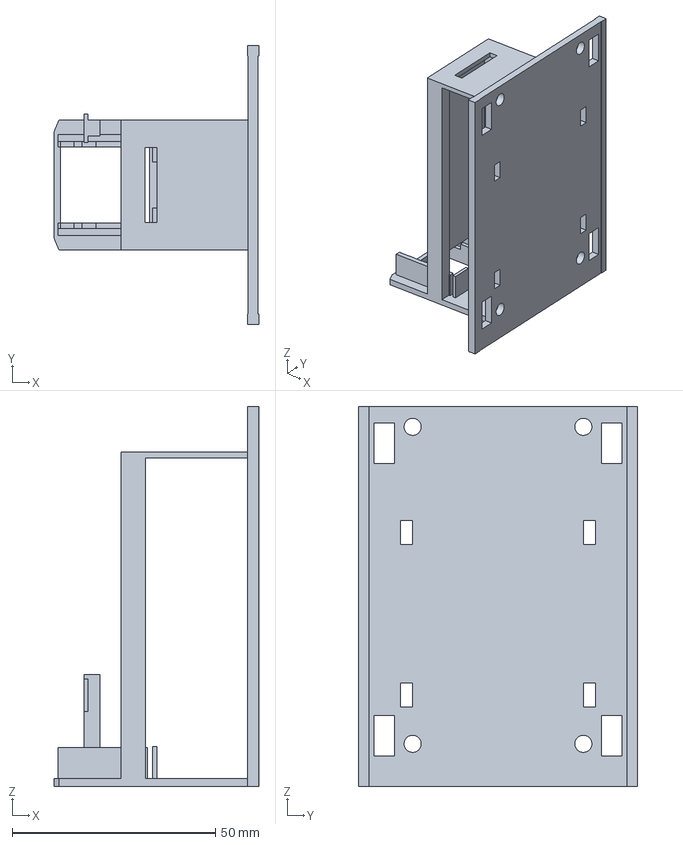
[picture p116: CAD file, 2026-10-28]
hardware/Print/1_Capsule_SLED_and_spacer_any_colour.3mf
50.3 x 68.6 x 93.5 mm
