sfandetti/meetorbit/hardware/STL/Capsule_v1/Orbit_Capsule_tube.stl

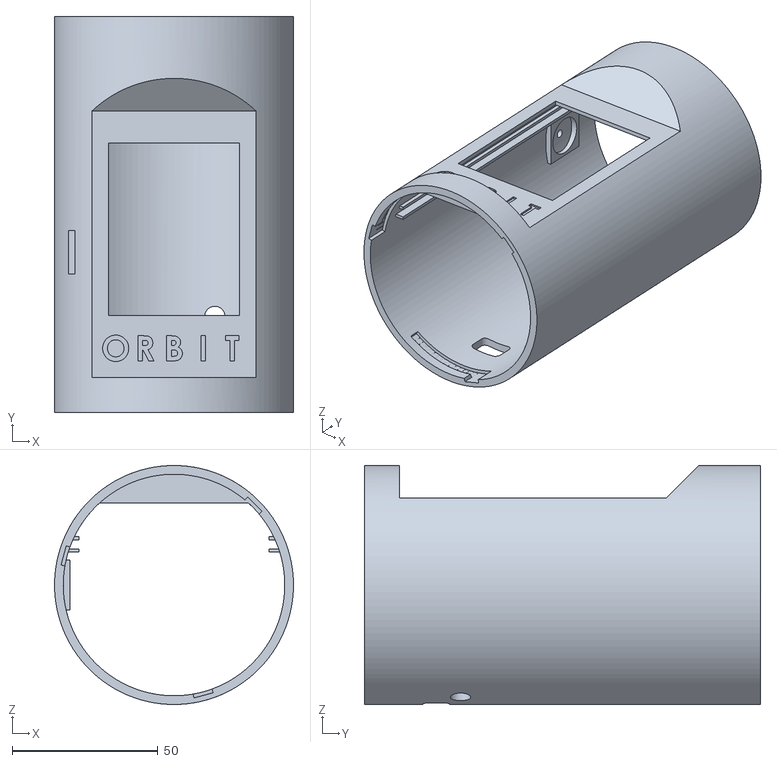
[picture p117: CAD file, 2026-10-28]
hardware/STL/Capsule_v1/Orbit_Capsule_tube.stl
82.0 x 136.0 x 82.0
