sfandetti/meetorbit/hardware/Print/1c_Capsule_SLED_TRAY_TEST_slice.3mf

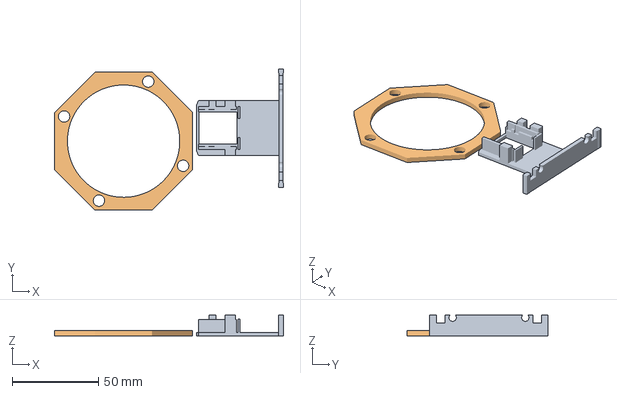
[picture p118: CAD file, 2026-10-28]
hardware/Print/1c_Capsule_SLED_TRAY_TEST_slice.3mf
132.6 x 81.9 x 12.0 mm
Orbit_Capsule_sled
Orbit_Capsule_spacer_top_3mm_print.stl
