sfandetti/meetorbit/hardware/Print/3_Capsule_LIDS_grey.3mf

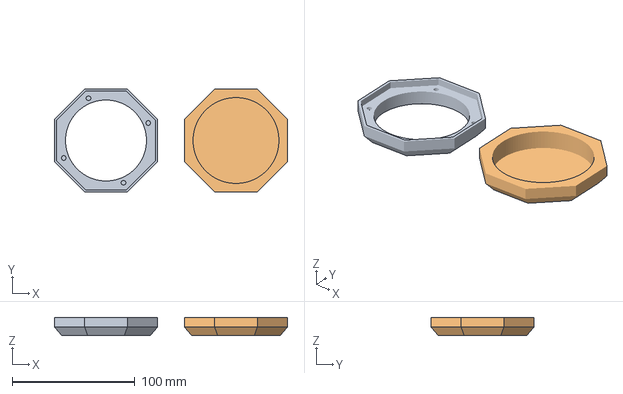
[picture p119: CAD file, 2026-10-28]
hardware/Print/3_Capsule_LIDS_grey.3mf
190.0 x 84.0 x 15.0 mm
Orbit_Capsule_lid_top
Orbit_Capsule_lid_bot
