sfandetti/meetorbit/hardware/STL/Capsule_v1/Orbit_Capsule_sled_tray_test_slice.stl

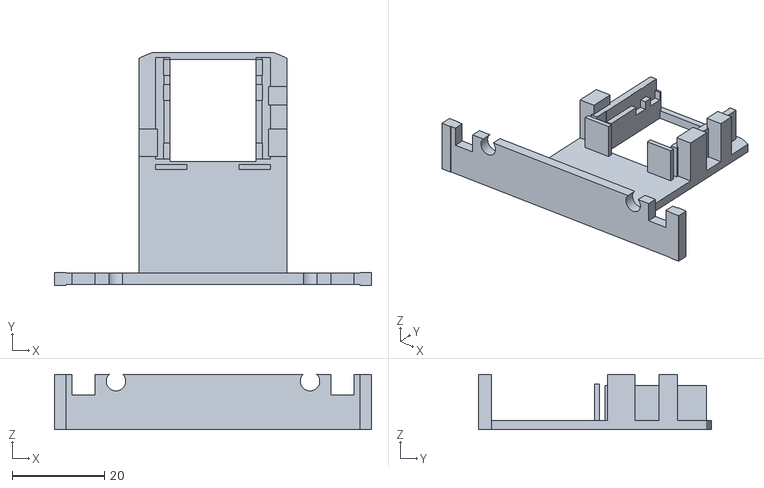
[picture p120: CAD file, 2026-10-28]
hardware/STL/Capsule_v1/Orbit_Capsule_sled_tray_test_slice.stl
68.6 x 50.4 x 12.0
