sfandetti/meetorbit/hardware/STL/Capsule_v1/Orbit_Capsule_collar_bot.stl

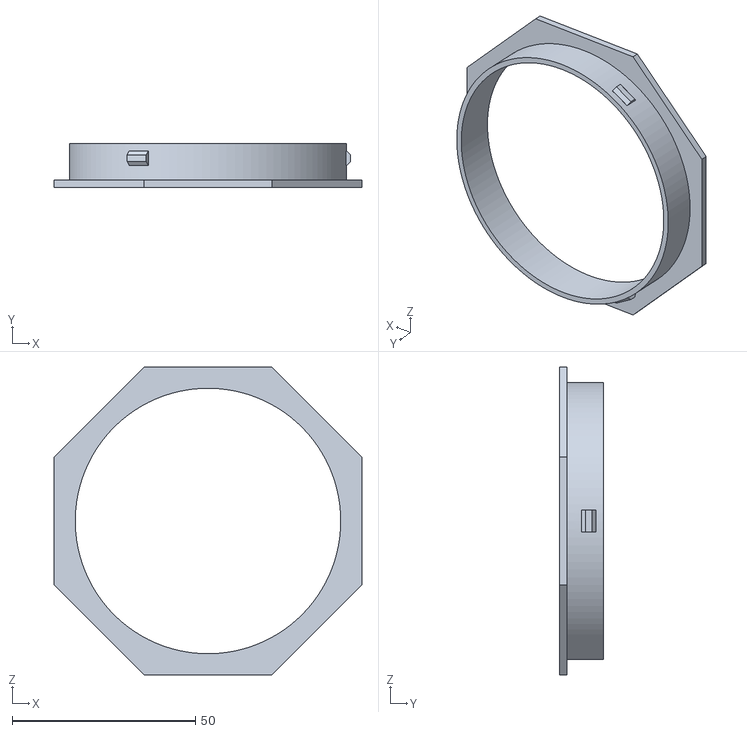
[picture p121: CAD file, 2026-10-28]
hardware/STL/Capsule_v1/Orbit_Capsule_collar_bot.stl
84.0 x 12.0 x 84.0
