sfandetti/meetorbit/hardware/Print/5_Capsule_BUTTON_PLUNGERS_x3_white.3mf

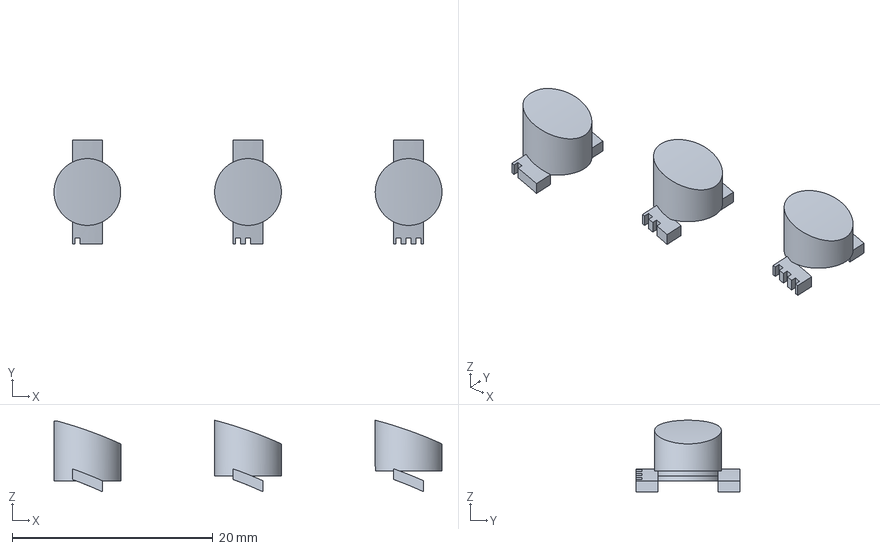
[picture p122: CAD file, 2026-10-28]
hardware/Print/5_Capsule_BUTTON_PLUNGERS_x3_white.3mf
38.6 x 10.4 x 7.13 mm
