sfandetti/meetorbit/hardware/Print/1d_Capsule_SPEAKER_SPACER_flat_1.6mm.3mf

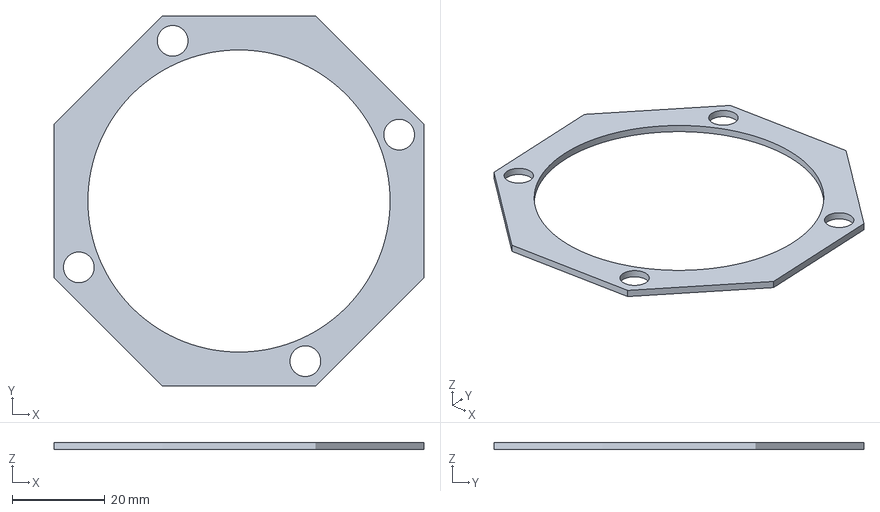
[picture p124: CAD file, 2026-10-28]
hardware/Print/1d_Capsule_SPEAKER_SPACER_flat_1.6mm.3mf
79.6 x 79.6 x 1.60 mm
