sfandetti/meetorbit/hardware/Print/4_Capsule_COLLARS_and_button_ring_colour.3mf

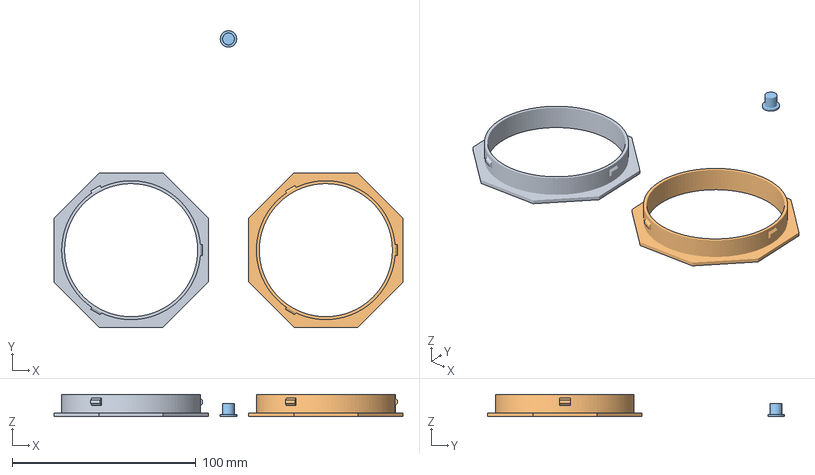
[picture p125: CAD file, 2026-10-28]
hardware/Print/4_Capsule_COLLARS_and_button_ring_colour.3mf
190.0 x 161.5 x 12.0 mm
Orbit_Capsule_collar_top
Orbit_Capsule_collar_bot
Orbit_Capsule_button
