sfandetti/meetorbit/hardware/STL/Capsule_v1/Orbit_Capsule_spacer_top.stl

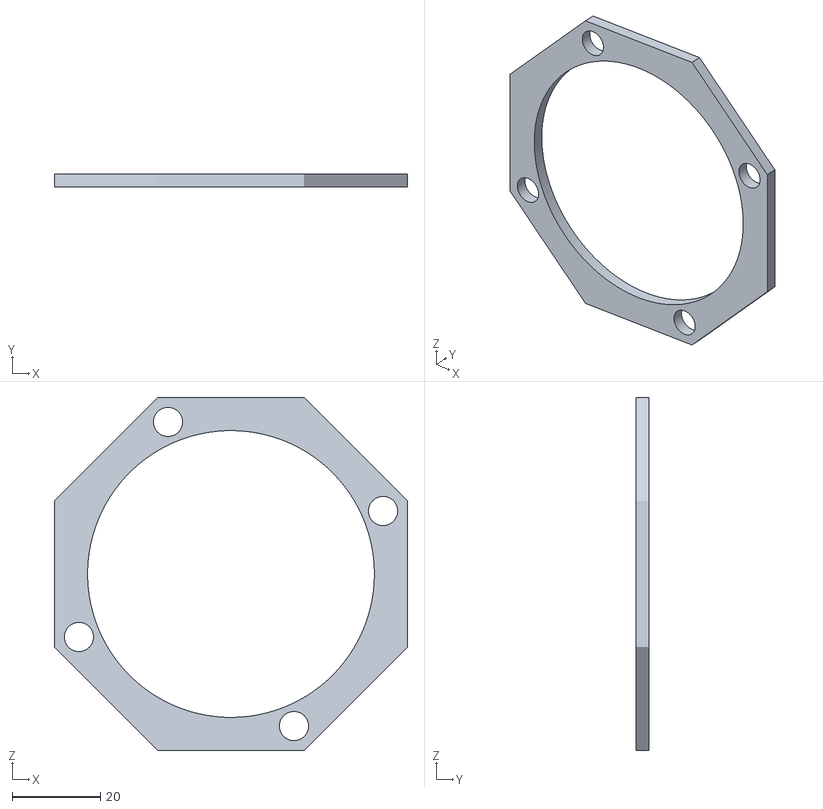
[picture p126: CAD file, 2026-10-28]
hardware/STL/Capsule_v1/Orbit_Capsule_spacer_top.stl
80.0 x 3.00 x 80.0
