sfandetti/meetorbit/hardware/STL/Capsule_v1/Orbit_Capsule_lid_bot.stl

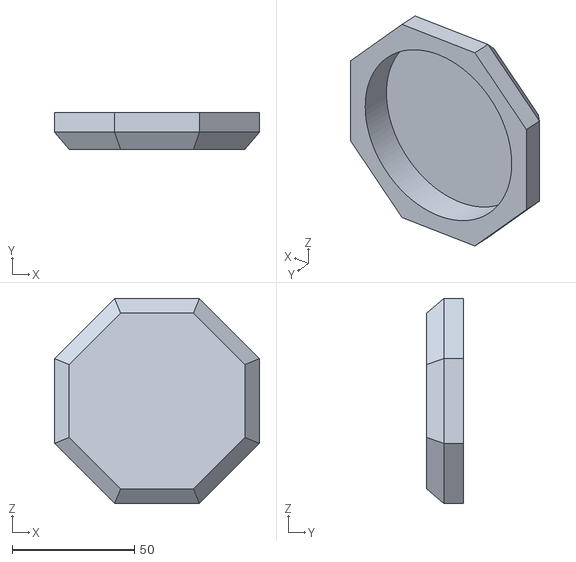
[picture p127: CAD file, 2026-10-28]
hardware/STL/Capsule_v1/Orbit_Capsule_lid_bot.stl
84.0 x 15.0 x 84.0
