sfandetti/meetorbit/hardware/STL/Capsule_v1/Orbit_Capsule_plunger_gap08.stl

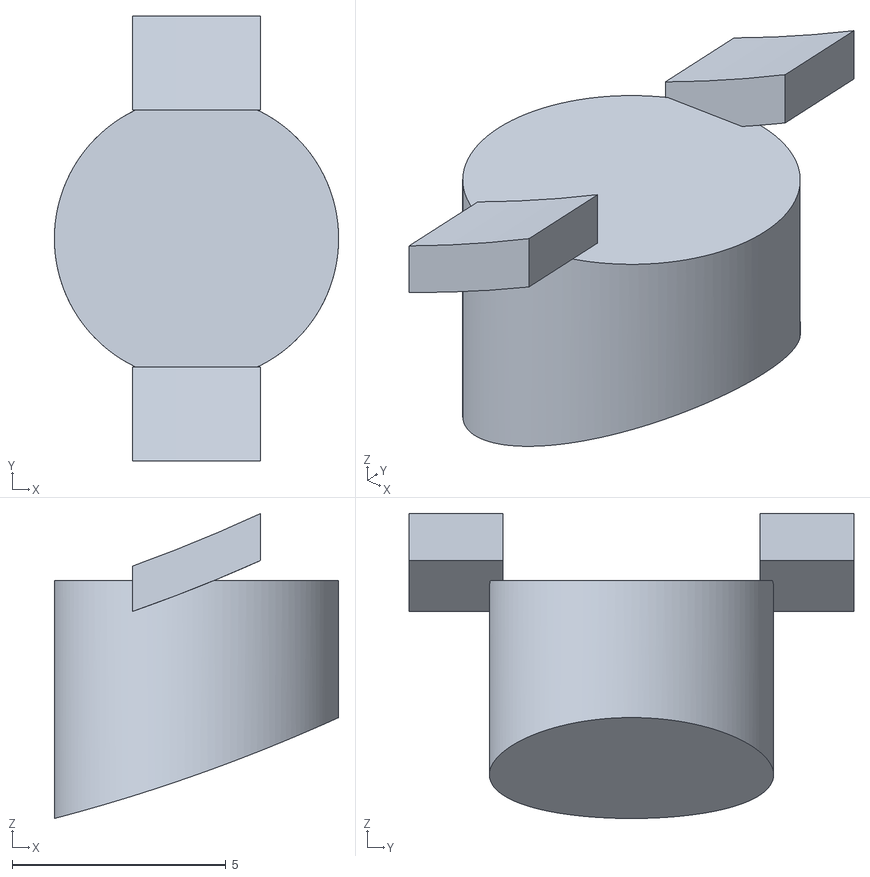
[picture p128: CAD file, 2026-10-28]
hardware/STL/Capsule_v1/Orbit_Capsule_plunger_gap08.stl
6.65 x 10.4 x 7.13
