sfandetti/meetorbit/hardware/STL/Capsule_v1/Orbit_Capsule_lid_top.stl

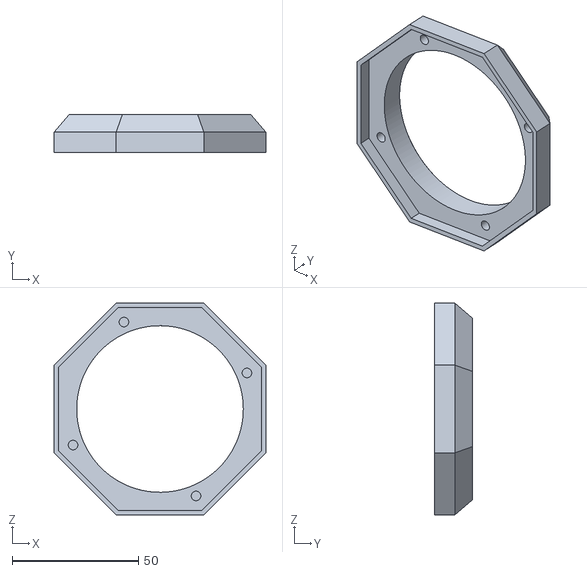
[picture p129: CAD file, 2026-10-28]
hardware/STL/Capsule_v1/Orbit_Capsule_lid_top.stl
84.0 x 15.0 x 84.0
