sfandetti/meetorbit/hardware/STL/Capsule_v1/Orbit_Capsule_screen_post.stl

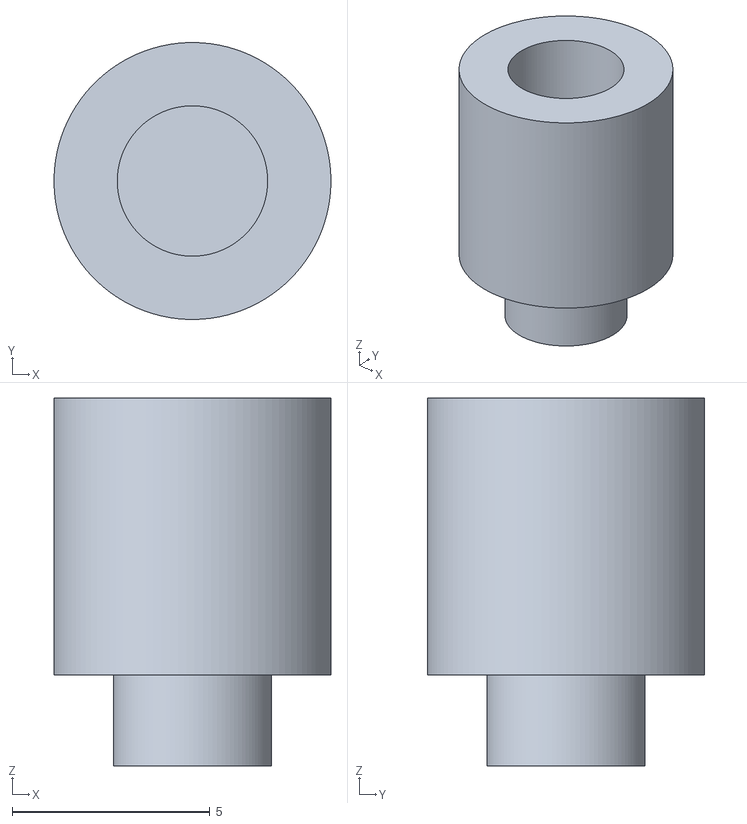
[picture p130: CAD file, 2026-10-28]
hardware/STL/Capsule_v1/Orbit_Capsule_screen_post.stl
7.00 x 7.00 x 9.30
