sfandetti/meetorbit/(list of files, cad)

Other CAD files:
hardware/STL/Capsule_v1/Orbit_Capsule_tube_TEST_band_usbc_button.stl
hardware/Print/2b_Capsule_TUBE_TEST_band_usbc_button.3mf
hardware/STL/Capsule_v1/Orbit_Capsule_collar_top.stl
hardware/STL/Capsule_v1/Orbit_Capsule_spacer_top_3mm_print.stl
hardware/STL/Capsule_v1/Orbit_Capsule_tube_with_pad.stl
hardware/STL/Capsule_v1/Orbit_Capsule_speaker_spacer_flat_1p6.stl
hardware/STL/Capsule_v1/Orbit_Capsule_sled.stl
hardware/STL/Capsule_v1/Orbit_Capsule_button_plungers_x3.stl
hardware/STL/Capsule_v1/Orbit_Capsule_screen_post_sheet_x20.stl
