sfandetti/meetorbit/hardware/Build_guide/Orbit_Build_Guide_BUILD1.html

Orbit · Capsule v1 · Build 1 · your wire colours

# Capsule Build Guide · Build 1

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

0 of 0 steps done

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

## Before you start

Lithium batteries

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

### Printed parts

- 1_SLED: sled + 3 mm speaker spacer. Reprint the sled if yours is from before Oct 18 (new drop-in power-board tray). 1c_ is a quick test print of just that tray.
- 1b_SCREEN_POSTS: sheet of 20 posts (you need 4)
- 2_TUBE: the tube. Already printed? Keep it: just open the mic pocket (step D3).
- 3_LIDS: top lid (open, the speaker shows through), bottom lid
- 4_COLLARS: both collars + power button
- 0_TEST speaker-hole ring: optional, already done

### Electronics

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

### Hardware

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

### Tools and wire

- Soldering iron, solder, flux
- Multimeter with a beep (continuity) mode
- Wire: your 22 AWG silicone (orange, green, red, black, blue, yellow, white), plus electrical tape for tags
- Strippers, flush cutters, tweezers
- 2.5 mm hex key, small flat screwdriver

Build 1 wire colours

This copy is for your first build, using only the wire you have now. The diagrams and pictures still show purple, grey and brown; use the right-hand column of this table for the real wire.

Colour in the diagrams | What it carries | Your wire for this build
Red | 5V power (and battery +) | Red
Black | Ground (GND, battery −) | Black
Orange | 3.3V for the mic | Orange
Blue | IO22 audio clock (mic SCK + amp BCLK) | Blue
Green | IO27 left/right clock (mic WS + amp LRC) | Green
Yellow | IO35 mic data | Yellow
Purple | IO4 speaker data (amp DIN) | White
Grey | IO16 LED data | White + tape band
Brown | Power button (K pad) | Yellow + tape band

You have 7 colours and there are 9 signals, so two colours are used twice. Purple and grey in the diagrams are white wire, and brown is yellow wire. The ones marked “tape band” get a small wrap of electrical tape near both ends, so you can tell them apart. The doubled-up wires never run side by side: the yellow button wire stays down at the power board, far from the yellow mic wire at the top, and the taped white IO16 wire stays coiled up until you add the LEDs. Rough wire lengths: battery to power board 8 cm, power board to screen 12 cm, power board to amp 14 cm, screen plugs to amp 12 cm, screen plugs to mic 18 cm, speaker 15 cm.

A

## Electronics

Do it in this order

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

### Battery wires to the power board

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

### Power button

2. Solder an 8 cm wire to two diagonally opposite legs of the 6×6 button. Check with the multimeter's beep mode: it should beep only while you press.
  Solder one wire to K and the other to B− (ground), on the USB-A side like A1. B− can take two wires; tin it well. Use yellow with a tape band for the K wire and black for B−.

### 5V output harness

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

### First power test

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

Diagram 2 · Audio. The mic and amp share the two clock wires (IO22, IO27). Each also gets its own data wire: mic → IO35, amp ← IO4 (purple in the diagram = your white wire). Grey pins stay empty.

### Power the screen

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

### Find the IO4 and IO16 pads

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

### Solder the two pad wires

3. Solder a plain white wire to the IO4 pad of LED1 (amp data) and a white + tape band wire to the IO16 pad of LED1 (LEDs, later). Put the tape on the IO16 wire before you solder, so you can't mix them up. These pads are tiny and 22 AWG is thick: strip only 2 mm, tin the wire, add flux, and touch the iron for a second or two. If it won't sit on the pad, splice a short piece of thin wire from a spare CYD cable onto the end and solder that instead.
  Put a dot of hot glue over each wire about 1 cm from the joint, so a tug can't rip the pad off. The RGB LED may flicker faintly when sound plays. That's harmless; desolder its red and green resistors if it bothers you.

### CN1 and P3 cables

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

### Wire the mic (18 cm wires)

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

### Wire the amp

6. Your amp already has its pins soldered, pointing down. Solder the wires straight onto the pins, close to the board, and heat-shrink each one. Keep the wires running straight down: the pins pass through a slot in the sled shelf. Leave the wires long and trim them once everything is mounted: VIN and GND 18 cm, BCLK and LRC 15 cm, DIN 20 cm. The DIN wire is the same wire as the screen's IO4 pad wire (A7): solder it to both while the amp sits loose next to the screen.
  - VIN ← 5V branch · GND ← GND branch
  - BCLK ← IO22 (blue) · LRC ← IO27 (green)
  - DIN ← IO4 pad (white, no tape)
  - GAIN and SD: nothing

### Bench test

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

B

## Caps and inserts

### Dry-fit first

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

### Heat-set inserts (8)

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

### Speaker into the top lid

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

### Spacer

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

### Glue the top collar to the top lid

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

### Glue the bottom collar to the bottom lid

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

Why the caps line up

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

C

## Mount everything on the sled

Do these in order. Each picture shows the sled after that step.

### Power board in the bottom tray

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

### Button on its post

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

Push button glued on the post above the power board

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

### Battery holder

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

### Amp on the top shelf

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

Purple amp on the top shelf, yellow header pins through the slot, green terminal on top

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

### Screen on the front

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

CYD screen screwed onto the front of the sled with four screws

  Screen on its 4 posts, held by 4 M3×6 screws into the heat-set inserts.

### Tidy

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

### How the wires run on the sled

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

Front side: the CN1 and P3 cables leave the top-right plugs and go through the upper pass-through slot, then down the right side, behind the batteries, to the amp pins. The plain white IO4 wire runs from its pad up the right edge and joins them. The five mic wires go up over the top of the screen and around the inside of the tube to the left wall.

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

Back of the sled, fully wired (mic and speaker wires not shown here).

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

Front of the sled with the screen drawn see-through, so you can see the plugs and where each cable goes. Purple here = your plain white wire, grey = white with a tape band.

D

## Final assembly

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

### Batteries in, power off

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

### Slide the sled in

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

### Mic into its pocket

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

### Power button

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

### Speaker wires to the amp

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

### Top cap on

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

### Test

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

### Bottom cap on

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

## Pin map for the firmware

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

## If something's wrong

### Nothing turns on

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

### Screen on, no sound

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

### Mic silent or noisy

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

### Sled won't slide

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
