sfandetti/meetorbit/hardware/Build_guide/Orbit_Face_preview.html

# ORBIT FACE

Preview at the real screen size (240 × 320). Big eyes that wander, blink and follow, a mouth that moves when Orbit talks. Tap the screen to make Orbit look at your finger.

ORBIT

## Mood

Idle Talking Listening Happy Thinking Sleepy

## Eye colour

## Eye style

Eyes with pupils Solid glow eyes

The mouth always takes the same colour as the eyes. In Orbit's app, these same choices (colour and eye style) become a "Customize face" setting.

Everything here is drawn with simple shapes (rounded rectangles and circles), so the same face can run on Orbit's ESP32 screen at full speed. In the real device, "Talking" moves the mouth with the speaker's sound level and "Listening" reacts to the mic.
