sfandetti/meetorbit/hardware/Build_guide/GPIO4_is_an_LED1_pad.jpg

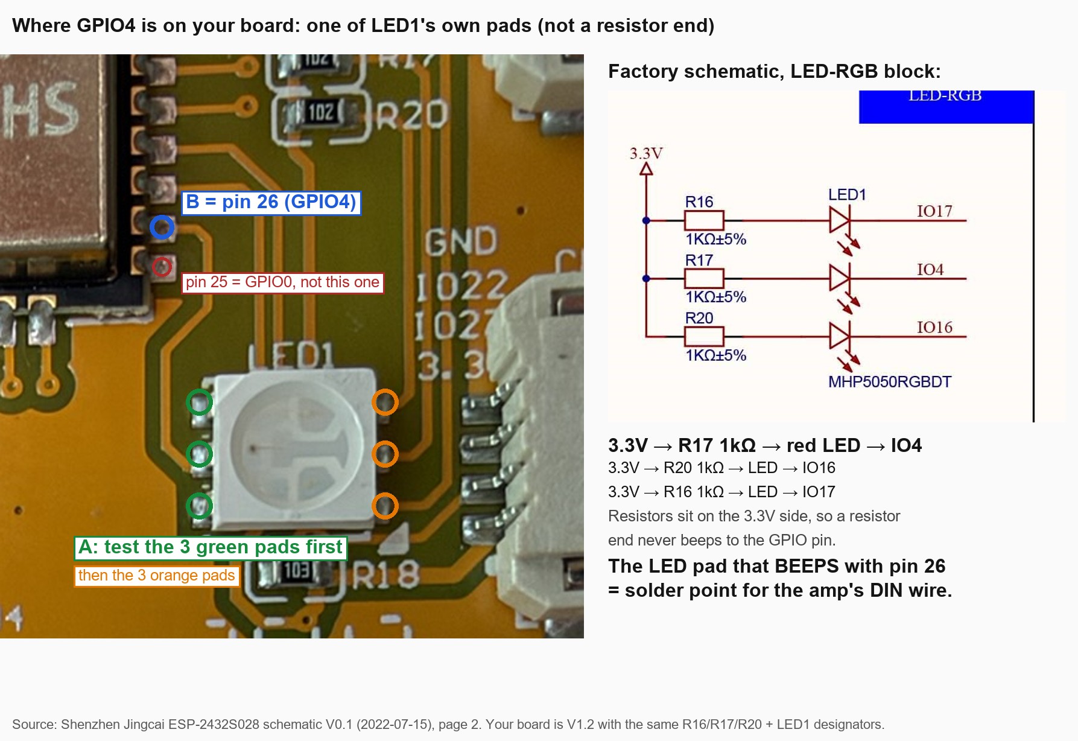
hardware/Build_guide/GPIO4_is_an_LED1_pad.jpg
