sfandetti/meetorbit/hardware/Build_guide/GPIO4_takeoff_check.jpg

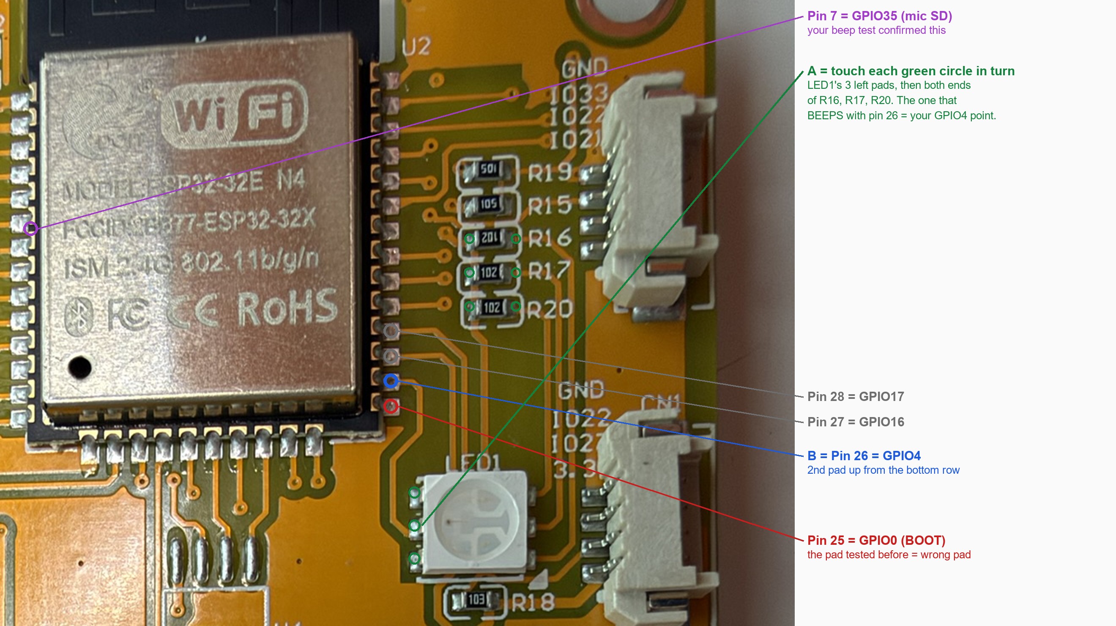
hardware/Build_guide/GPIO4_takeoff_check.jpg
