sfandetti/meetorbit/hardware/Build_guide/Mic_signal_check.jpg

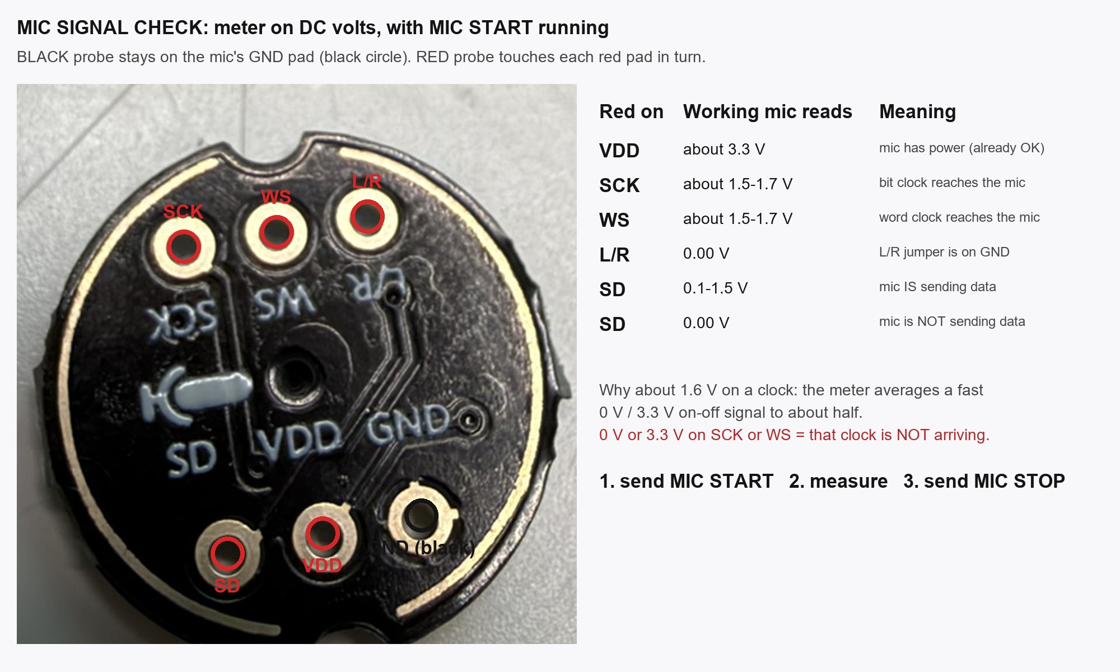
hardware/Build_guide/Mic_signal_check.jpg
