sfandetti/meetorbit/hardware/Build_guide/Orbit_harness_plugs_labelled.jpg

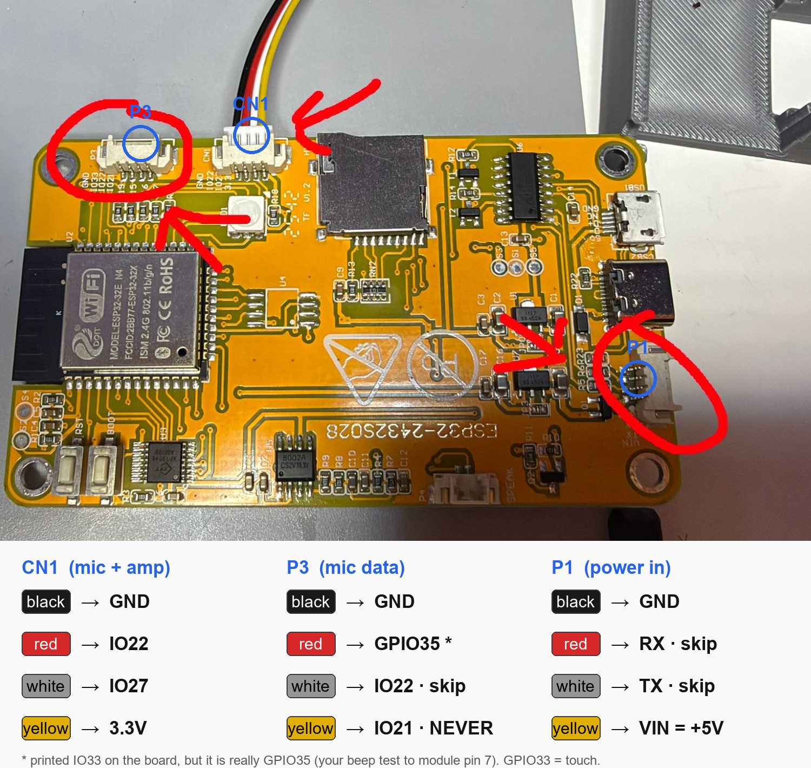
hardware/Build_guide/Orbit_harness_plugs_labelled.jpg
