sfandetti/meetorbit/hardware/Build_guide/Orbit_Wiring_Poster.jpg

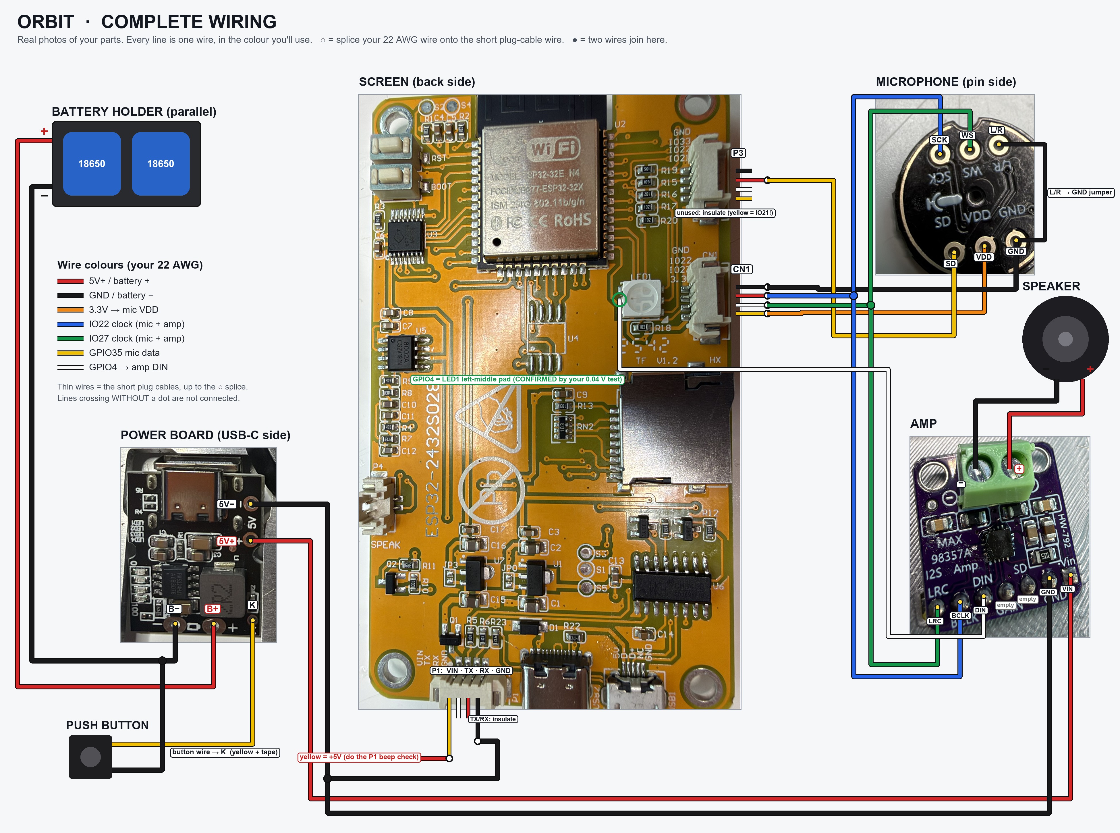
hardware/Build_guide/Orbit_Wiring_Poster.jpg
