sfandetti/meetorbit/website/assets/screens/lying/setup-ai-inbox.png

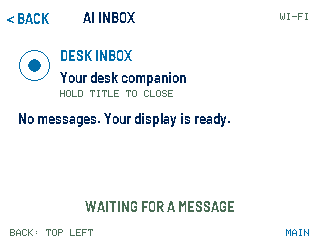
website/assets/screens/lying/setup-ai-inbox.png
