sfandetti/meetorbit/website/assets/screens/lying/setup-brightness.png

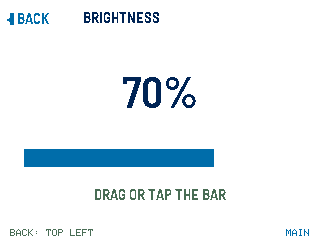
website/assets/screens/lying/setup-brightness.png
