sfandetti/meetorbit/website/assets/screens/lying/setup-colors.png

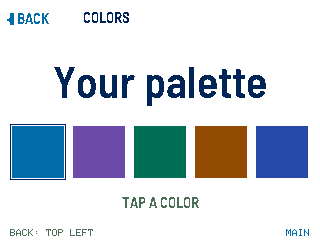
website/assets/screens/lying/setup-colors.png
