sfandetti/meetorbit/website/assets/screens/lying/setup-device-memory.png

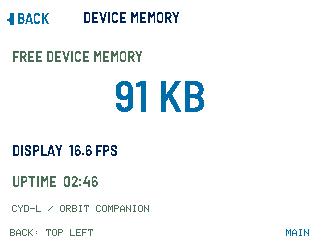
website/assets/screens/lying/setup-device-memory.png
