sfandetti/meetorbit/website/assets/screens/lying/setup.png

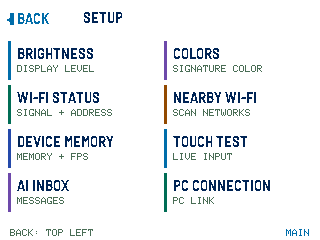
website/assets/screens/lying/setup.png
