sfandetti/meetorbit/website/assets/screens/standing/setup-ai-inbox.png

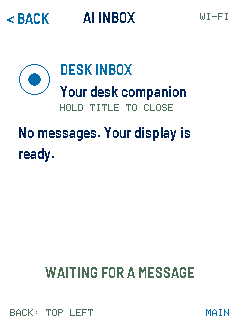
website/assets/screens/standing/setup-ai-inbox.png
