sfandetti/meetorbit/website/assets/screens/standing/setup-brightness.png

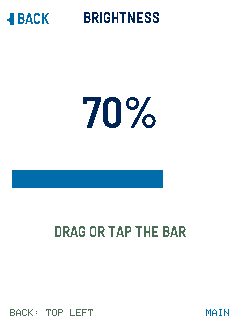
website/assets/screens/standing/setup-brightness.png
