sfandetti/meetorbit/website/assets/screens/standing/setup-colors.png

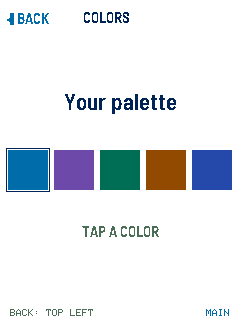
website/assets/screens/standing/setup-colors.png
