sfandetti/meetorbit/website/assets/screens/standing/setup-device-memory.png

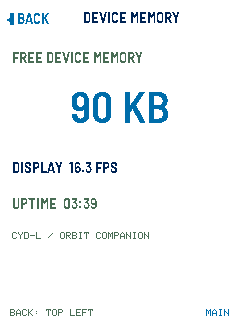
website/assets/screens/standing/setup-device-memory.png
