sfandetti/meetorbit/website/assets/screens/standing/setup.png

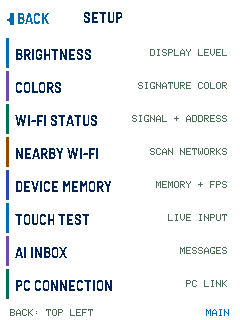
website/assets/screens/standing/setup.png
