sfandetti/meetorbit/docs/VALIDATION.md

# Screenshot and feature refresh — 28 October 2026

- Read saved captures only; no device screen, theme, rotation, capture or firmware commands were sent for this update.
- 92 supplied images copied byte-for-byte and checked against SHA-256 hashes: 42 landscape, 42 portrait, 8 theme samples.
- Private network/pairing screens excluded. The landscape file named ai-face shows Home; the public label identifies the actual view.
- Added home shortcuts, device alarm/snooze, sound machine, theme comparisons and two games. Existing Hue, telemetry, Sentry and display images are refreshed.
- Current companion test suite: **141 passed, 0 failed**. Tests use mocked integrations; no actual device, camera or AI-provider validation was performed here.
- **235** website local link, asset and anchor references checked; no missing targets.
- Current software snapshot contains 161 source files. Common provider-token/private-key patterns had no matches in inspected source text.
- Public source ZIP rebuilt with current source and font notices; download checksums updated.

The physical working Orbit folder was read for source reference only. Firmware was not compiled or uploaded. Production hardware, signed installers and matched prebuilt firmware remain unreleased.

The final source snapshot was refreshed after the pause and its suite rerun: 141 tests pass. The audio-crackle improvement was reported by Seth; this publishing task did not run a listening test or flash firmware. A dated technical handoff is requested before publishing a tested/versioned audio release.
