sfandetti/meetorbit/website/assets/screens/lying/setup-touch-test.png

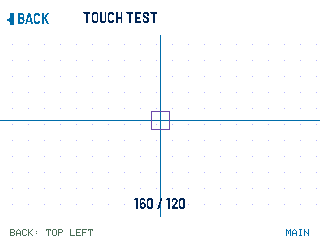
website/assets/screens/lying/setup-touch-test.png
