sfandetti/meetorbit/website/assets/screens/standing/setup-touch-test.png

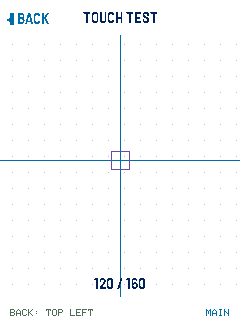
website/assets/screens/standing/setup-touch-test.png
