sfandetti/meetorbit/software/firmware/OrbitDevice/theme_fonts.h

// Rasterized SIL Open Font License fonts from google/fonts. See web/fonts licenses.
#pragma once
const uint8_t OrbitOfficeSmallBitmaps[] PROGMEM={0x63,0x18,0xc2,0x10,0x80,0x3,0x18,0xd6,0xb4,0x0,0x0,0x0,0x0,0x0,0x1b,0x4,0xc7,0xf9,0xfe,0x33,0xc,0x87,0xf1,0xfc,0x26,0x19,0x80,0x10,0x10,0x7c,0x66,0x46,0x60,0x78,0x1c,0x6,0x46,0x46,0x7c,0x38,0x10,0x38,0x87,0x98,0x49,0x7,0xb0,0x3a,0x0,0x60,0x5,0xc0,0xde,0x9,0x21,0x9e,0x11,0xc0,0x3c,0x1f,0x86,0x61,0x98,0x3c,0xe,0x7,0xd1,0xb6,0x47,0x1f,0xc3,0xd8,0xdb,0x0,0x0,0x0,0x0,0x63,0x11,0x8c,0x63,0x18,0xc6,0x10,0xc6,0x0,0x61,0x8c,0x63,0x8,0x46,0x31,0x8c,0x66,0x0,0x23,0xa3,0x3a,0x20,0x0,0x0,0x0,0x0,0x0,0x10,0x23,0xfb,0xe1,0x2,0x0,0x0,0x69,0x20,0x7b,0xe0,0x0,0x0,0x0,0x66,0x0,0x8,0x61,0x84,0x30,0xc2,0x18,0x61,0x8c,0x0,0x3c,0x7e,0x66,0x46,0x46,0x46,0x46,0x46,0x66,0x7e,0x3c,0x77,0x8c,0x63,0x18,0xc6,0x31,0x8c,0x38,0xf9,0x1a,0x30,0xc1,0x86,0x18,0x70,0xfd,0xf8,0x7c,0xf8,0x30,0xc3,0x81,0x81,0x23,0x44,0xf8,0xe0,0x18,0x30,0x30,0x20,0x66,0x66,0xfe,0xfe,0x6,0x6,0x6,0x7c,0xf9,0x2,0x5,0xcf,0x81,0x83,0x66,0xf8,0xe0,0x38,0xf9,0x12,0x5,0x8f,0x99,0xa3,0x66,0xf8,0xe0,0xfd,0xf8,0x30,0x60,0x83,0x6,0x8,0x30,0x60,0xc0,0x38,0xf9,0x1a,0x37,0xcf,0x99,0x23,0x46,0xf8,0xe0,0x38,0xf9,0x12,0x34,0x6f,0xcf,0x83,0x46,0xf8,0xe0,0x63,0x0,0x0,0x31,0x80,0x66,0x0,0x6,0x64,0x40,0x2,0x1c,0xe7,0xf,0x7,0x81,0x80,0xfe,0x0,0x7,0xf0,0x0,0x0,0x0,0x81,0xc0,0xe0,0x71,0xef,0x30,0x0,0x38,0xfb,0x16,0x20,0xc3,0xc,0x18,0x0,0x20,0xc0,0x2,0x1,0xfc,0x30,0xc2,0x56,0x4f,0x24,0x92,0x49,0x24,0xb6,0x4f,0xc6,0x48,0x3f,0x1,0xe0,0x18,0x1c,0x3c,0x3c,0x34,0x26,0x66,0x66,0x7e,0x43,0xc3,0x7c,0x7e,0x62,0x62,0x7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
const GFXfont OrbitRetroMedium PROGMEM={(uint8_t*)OrbitRetroMediumBitmaps,(GFXglyph*)OrbitRetroMediumGlyphs,32,126,23};
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
