sfandetti/meetorbit/(commit log)

2026-10-28 Publish Orbit open-source prototype with hardware, current AI and Hue source, guides and screen gallery
    [0_Capsule_TEST_speaker_hole_ring.3mf, 1_Capsule_SLED_and_spacer_any_colour.3mf, 1b_Capsule_SCREEN_POSTS_x20_sheet.3mf, 1c_Capsule_SLED_TRAY_TEST_slice.3mf, 1d_Capsule_SPEAKER_SPACER_flat_1.6mm.3mf, 2_Capsule_TUBE_graphite.3mf, 2b_Capsule_TUBE_TEST_band_usbc_button.3mf, 3_Capsule_LIDS_grey.3mf]
2026-10-28 Include CAD render references and Orbit symbol
2026-10-29 Refresh device screenshots, feature coverage and release handoff
